positron-nb/starDust_wreckingball/Requirements_Compliance.csv

Requirement ID | Source | Exact requirement from the problem statement / template | Mandatory or design-dependent | Proposed design response | Evidence in CAD or documentation | Verification method | Status
R-01 | PS p.1, Hardware & Mechanical Constraints | Robot Structure: Must be a spherical robot (ball-shaped) with a strict diameter between 2.0 feet and 2.5 feet. | Mandatory | 700 mm (2.30 ft) PC sphere; max caliper 700.7 mm over tape band, min 696.3 mm across recessed hubs. | Dimensioned_Views.png; cad/out/analysis_results.json (dimensions); wb700_params.py D_shell | CAD caliper check over 2562 directions incl. all exterior parts (done); +/-7 mm tolerance case (done); physical go/no-go gauge check in Phase 3 | Satisfied
R-02 | PS p.1 | Internal Housing: All core computing hardware, power sources, actuators, and electronics must fit completely inside the spherical body. | Mandatory | Every electronic/power/actuator part is inside the shell; hub devices recessed in flush polar hubs. | Internal_Layout.png; Cross_Section.png; max non-skin radius 349.0 mm (recessed 1.0 mm) | CAD radius/envelope check (done); inspection in Phase 3 | Satisfied
R-03 | PS p.1 | Peripheral Limits: External sensors, mounts, or camera lenses cannot extend more than 0.5 feet beyond the surface of the outer shell. | Mandatory | No external sensors, mounts or camera pods; camera internal behind clear PC. | Dimensioned_Views.png envelope panel; analysis_results.json external_sensors_or_mounts = 0 | CAD protrusion check (done) | Satisfied
R-04 | PS p.1 | Power Supply: Must be strictly onboard battery-powered. No tethered cables, external power lines, or remote power feeds are allowed. | Mandatory | 6S1P Li-ion 21700 pack (about 97 Wh) on the steering bob; charge port used only between runs with the arming plug removed. | Power_Distribution.png; Preliminary_BOM.csv (BATTERY) | Design review (done); inspection in Phase 3 | Satisfied
R-05 | PS p.1, Deliverables | Phase 1 CAD & System Document: Complete CAD assembly illustrating internal electronic layout, center-of-gravity placement, and system architecture schematic. | Mandatory | Parametric CadQuery assembly (STEP/STL/GLB) with labelled electronics, CG figure and architecture diagrams. | cad/; figures/; Phase1_Technical_Design_Document.pdf; Phase1_CAD_Abstract.pdf | Package review against this matrix (done); organiser screening | Satisfied
R-06 | PS p.2, Format | Round 1 (Abstract & Design Audit): Online screening based on CAD models, system schematics, and dimension compliance. | Mandatory | Abstract follows the official template; CAD renders, schematics and dimension compliance included. | Phase1_CAD_Abstract.pdf/.docx/.md | Submission by the team (pending format confirmation, Q2) | Partially satisfied
R-07 | PS p.1, Deliverables | Phase 2 Technical Simulation Report: Mathematical analysis validating actuator torque across inclined planes, balance stability, and safety kill-switch mechanism implementation. | Mandatory | Preliminary quasi-static torque check only; full analysis is a Phase 2 standby workstream. | Ramp_Capability.png; FUTURE_PHASES_STANDBY.md | Phase 2 dynamic model and report | Partially satisfied
R-08 | PS p.2, Format | Round 2 (Virtual Simulation Audit): Virtual evaluation of motor sizing calculations, torque requirements for the 0.8 ft ramp, and wireless kill-switch mechanics. | Mandatory | Ramp torque relation and pendulum limit established; motor class and kill-switch architecture defined. | TDD sections 14 and 16; Ramp_Capability.png | Phase 2 report | Partially satisfied
R-09 | PS p.2, Deliverables | Phase 3 Physical Prototype: Fully operational ball bot fielded live on-campus at IIT Bombay for technical evaluation and track trials. | Mandatory | On standby; manufacturing and assembly approach defined. | TDD section 18; FUTURE_PHASES_STANDBY.md | Phase 3 build and trials | Unresolved
R-10 | PS p.2, Round 3 Day 1 | Day 1: Technical inspection (size check, weight, electrical isolation, emergency kill-switch validation) and preliminary practice runs. | Mandatory | Diameter margins; mass estimate 17.0 kg; external arming plug for isolation; 3-channel e-stop with self-test. | Dimensioned_Views.png; Center_of_Gravity.png; Power_Distribution.png | Phase 3 inspection; 'electrical isolation' definition requested (Q8) | Partially satisfied
R-11 | PS p.2, Track | Visual Guidance: Track boundaries are defined by color-coded cone barriers: Red Cones: Located on the right side of the track. Yellow Cones: Located on the left side of the track. | Design-dependent | HSV segmentation of red/yellow cones; boundary model yellow = left, red = right. | Software_Flowchart.png; Camera_FOV.png | Phase 2 dataset tests; Phase 3 calibration | Partially satisfied
R-12 | PS p.2, Sector 1 | Sector 1: The Gate Runway (0m - 15m) Straight acceleration stretch featuring wide chevron-patterned cone gates to allow onboard vision calibration. | Design-dependent | CALIBRATE state locks colour thresholds and exposure on the chevron gates while rolling slowly. | Software_Flowchart.png | Phase 2 simulation; Phase 3 runs | Partially satisfied
R-13 | PS p.2, Sector 2 | Sector 2: The Step-Up Ramps (15m - 35m) Three consecutive incline ramps with heights of 0.2 ft, 0.4 ft, and 0.8 ft, funneled through cone gates to test traction and motor torque. | Design-dependent | Pendulum capability 10.7 deg steady climb incl. rolling resistance (7.1-13.6 deg with 2-6 ballast plates); run-up energy estimate for steeper ramps (unverified); PU tape for grip. | Ramp_Capability.png; TDD section 14 | Phase 2 dynamic model once ramp geometry is known (Q3) | Partially satisfied
R-14 | PS p.2, Sector 3 | Sector 3: The Wrecking Zone (35m - 55m) Sector populated with low-density obstacles (foam, thermocol, cardboard). The robot must maintain course alignment using border cones while plowing through obstacles. | Design-dependent | Heavy low pendulum (cannot derail), PC shell, gyro heading hold + border cones, momentum of 1-1.5 m/s. | TDD sections 10 and 14 | Phase 2 impact analysis; Phase 3 barrier tests | Partially satisfied
R-15 | PS p.2, Sector 4 | Sector 4: The Pendulum Gauntlet (55m - 75m) Final hazard sector featuring a continuously swinging mechanical pendulum across the track before the finish line. | Design-dependent | Stop before swing plane, observe 2-3 swings, fit period/phase, commit and cross in the predicted window. | Software_Flowchart.png; TDD section 15 | Phase 2 Monte-Carlo timing; Phase 3 test pendulum | Partially satisfied
R-16 | PS p.3, Scoring | Each participating team is granted 3 restart attempts within their designated operational window, with only their top performance logged for official scoring. | Design-dependent | Charging through the hub port and a single-bolt service procedure support quick turnarounds. | TDD section 8.8 | Phase 3 rehearsal | Partially satisfied
R-17 | PS p.3, Scoring | FinalScore(Seconds) = RawRunTime + Penalties | Design-dependent | Reliability first, then a speed profile per sector; target top speed 2 m/s (design target, not a claim). | TDD sections 11 and 14 | Phase 2 simulation | Partially satisfied
R-18 | PS p.3, Team | Team Size: Maximum of 6 members per team. | Mandatory | Team placeholders provided for up to 6 members. | TDD section 1 | Team to confirm | Unresolved
R-19 | PS p.3, Timeline | Phase 1 Registration & CAD Abstract Submission October 25, 2026 | Mandatory | Package prepared; date confirmed on techfest.org on 2026-10-20. | research/Official_Sources_Verification.md | Team submits before the deadline | Partially satisfied
R-20 | PS p.3, General Rules 1 | All teams must register on techfest.org to receive an official Team ID for tracking and submissions. | Mandatory | Team ID placeholders in all documents. | Phase1_README.md | Team action | Unresolved
R-21 | PS p.4, General Rules 2 | Instructions for specific rounds would be communicated on time via registered mail IDs | Mandatory | Team to monitor the registered mailbox; format question Q2 prepared. | Open_Questions_for_Organizers.md | Team action | Unresolved
R-22 | PS p.4, General Rules 3 | Submissions must represent the team's original work. Using external AI tools during live rounds is strictly prohibited unless judges explicitly authorize it. | Mandatory | Package drafted with AI assistance; team must review and own every decision; disclosure question Q1 prepared. | Open_Questions_for_Organizers.md (Q1); Phase1_README.md | Team review + organiser answer | Unresolved
R-23 | PS p.4, General Rules 4 | Official announcements will be posted on techfest.org. All contest queries must be submitted through the official portal's Doubt section. | Mandatory | 13 questions prepared for the Doubts section. | Open_Questions_for_Organizers.md | Team action | Partially satisfied
R-24 | PS p.4, General Rules 6 | Autonomy: The robot must operate with 100% autonomy during its run. No manual remote control, external human intervention, or external processing offloads are allowed once the run begins. | Mandatory | All perception, estimation and planning on the Pi 5; control on the MCU; the only RF link is the inhibit-only e-stop; development laptop disconnected during runs. | System_Architecture.png | Addressed in design; verification pending (Phase 3 demonstration) | Partially satisfied
R-25 | PS p.4, General Rules 7 | Sensor Restrictions: Onboard cameras must serve as the primary sensor for path tracking and gate identification. Supplementary internal sensors (IMUs, encoders, distance sensors) are permitted for stabilization. | Mandatory | Camera Module 3 Wide is the primary sensor; IMU, encoders, shell-index and steering-angle sensors are internal. | System_Architecture.png; Electronics_Architecture.png | Design review (done) | Satisfied
R-26 | PS p.4, General Rules 8 | Cone Contact Penalties: Touching, knocking over, or running over any track cone incurs a +5 second penalty per instance added to the total run time. | Design-dependent | Lane-centring on both boundaries with margin; lean steering +/-22.9 deg static authority. | TDD sections 10 and 13 | Phase 2 simulation once track/gate width is known (Q4) | Partially satisfied
R-27 | PS p.4, General Rules 9 | Emergency Stop: Every robot must have an operational wireless emergency kill switch that can immediately stop all motor actuation during a run. | Mandatory | Heartbeat e-stop with independent supervisor: contactor open + driver PWM inputs gated to zero + changeover brake relays (break-before-make); latched; all actuators downstream of the contactor. | Power_Distribution.png; Electronics_Architecture.png; TDD section 16 | Addressed in design; verification pending (Phase 2 bench latency/fail-safe tests, Phase 3 inspection) | Partially satisfied
R-28 | PS p.4, General Rules 10 | Did Not Finish (DNF): A run is marked as DNF if the robot fails to move, loses complete control, suffers total power failure, or cannot clear an obstacle. | Design-dependent | Fail-safe stops, torque headroom management, ballast tuning, fused branches, BMS; risks tracked. | TDD section 19 | Phase 2/3 | Partially satisfied
T-01 | TPL Team identification | Team ID & Name: [Enter Team ID and Team Name] Institution: [Enter College / University Name] Team Lead Contact: [Name | Email | Phone Number] | Mandatory | Placeholders present; never invented. | Phase1_CAD_Abstract | Team to fill | Unresolved
T-02 | TPL 1 | CAD Renders Provided: [Insert Isometric View Render Link/Image] [Insert Cross-Sectional View Render Link/Image] | Mandatory | Both renders generated from the CAD. | Isometric_Render.png; Cross_Section.png | Visual inspection (done) | Satisfied
T-03 | TPL 1 | Shell Integrity: Material: [e.g., Polycarbonate / Carbon Fiber / Fiberglass] Exact Outer Diameter: [e.g., 2.2 feet] | Mandatory | Clear PC, 3 mm; OD 700.0 mm (2.297 ft); 700.7 mm over tape. | Dimensioned_Views.png | CAD (done) | Satisfied
T-04 | TPL 1 | The 0.5-Foot Limit Rule: [Dimension and confirm that all external sensor mounts or camera pods extend beyond the outer shell diameter] | Mandatory | No external mounts or pods (0 mm). | Dimensioned_Views.png | CAD (done) | Satisfied
T-05 | TPL 1 | CoG & Drive Mechanism: [Explain how the internal drive/pendulum mechanism moves and balances the robot. Provide initial calculated CoG coordinates relative to the geometric center] | Mandatory | CG (+1.4, -0.4, -87.2) mm from the CAD mass table; mechanism explained. | Center_of_Gravity.png; mass_table.csv | Reproducible calculation (done); hardware CG measurement in Phase 3 | Satisfied
T-06 | TPL 1 | Ramp-Climbing Capability: [Detail motor torque calculations and selection chosen to conquer the hardest ramp] | Mandatory | Quasi-static torque table, pendulum reaction limit, run-up speeds, motor class and selection targets. | Ramp_Capability.png; abstract section 1 | Phase 2 final sizing after ramp geometry (Q3) | Partially satisfied
T-07 | TPL 2 | Electrical Block Diagram: [Insert schematic / block diagram showing power distribution, microcontroller, sensor interfaces, and motor drivers] | Mandatory | System, electronics and power diagrams. | System_Architecture.png; Electronics_Architecture.png; Power_Distribution.png | Visual inspection (done) | Satisfied
T-08 | TPL 2 | Power Source & BMS: Confirmation: Strictly battery-powered (Yes/No) Chemistry, Voltage & Capacity: [e.g., Lithium Polymer, 24V, 5000mAh] Safeguards: [Detail onboard BMS and low-voltage cutoff (LVC) safeguards] | Mandatory | Yes; Li-ion 6S1P 21.6 V 4.5 Ah; BMS with LVC + software LVC stop + fuses. | Power_Distribution.png | Design review (done); thresholds with the selected BMS in Phase 2 | Satisfied
T-09 | TPL 2 | Actuation & Motor Control: Motor Specs: [RPM, Stall Torque] Driver Boards: [Model and specs for propulsion and steering drivers] | Mandatory | Target specs per drive motor at 24 V: >= 320 rpm no-load, >= 2 N m rated continuous, >= 4 N m stall (operating point 1.66 N m at 55 rpm, checked at 18 V); MDD20A / MD10C class drivers. | Abstract section 2; Electronics_Architecture.png | Phase 2 part selection | Partially satisfied
T-10 | TPL 2 | Safety Fail-Safes: Wireless Kill-Switch: [Outline wireless emergency kill-switch mechanism] Manual Disconnect: [Outline manual external power disconnect switch location] | Mandatory | Heartbeat e-stop (3 channels); anti-spark arming plug in the non-rotating left polar hub. | Dimensioned_Views.png (left view); Power_Distribution.png | Design review (done) | Satisfied
T-11 | TPL 3 | Software Flowchart: [Insert architecture flowchart showing state machine diagram and vision AI stack] | Mandatory | Concept-level flowchart. | Software_Flowchart.png | Visual inspection (done) | Satisfied
T-12 | TPL 3 | Primary Vision Processing / State Estimation & Control / Obstacle Handling Logic (Sector 4) | Mandatory | Concept descriptions in abstract section 3 and TDD sections 13-15. | Phase1_CAD_Abstract; TDD | Algorithms validated in Phase 2 | Partially satisfied
