positron-nb/starDust_wreckingball/Preliminary_BOM.csv

Item | Description | Group | Qty | CAD part IDs | Material / part class | Selected or reference part | Mass each (kg) | Mass total (kg) | Mass basis | CG x (mm) | CG y (mm) | CG z (mm) | Placeholder (PH) | Spec source | Notes | Cost
SHELL-HEMI | Clear polycarbonate hemisphere, OD 700 mm, 3 mm wall (R has 4 rim notches) | Shell + equatorial joint + tape | 2 | SH-01 SH-02 | Polycarbonate, clear | to be sourced (thermoformed PC dome) | 2.6984 (avg) | 5.3968 | CAD volume x density | 0.0 | -0.0 | 0.0 | no | design parameter | supplier, tolerance and wall uniformity to be confirmed (risk R9) | not quoted (Phase 3 procurement)
SPIGOT-BAND | Equatorial spigot band + 4 key tabs, clear PC 5 mm | Shell + equatorial joint + tape | 1 | SH-03 | Polycarbonate, clear |  | 0.3903 | 0.3903 | CAD volume x density | 0.0 | 0.0 | 0.0 | no |  | bonded in L hemisphere; R hemisphere slides over; held by axial preload through axle | not quoted (Phase 3 procurement)
PU-TAPE | Clear PU protective tape band, 0.35 mm (applied in narrow strips) | Shell + equatorial joint + tape | 1 | SH-04 | TPU film 0.35 mm | 3M 8671 / 8671HS class | 0.1848 | 0.1848 | CAD volume x density | 0.0 | 0.0 | 0.0 | no | 3M TDS: transparent TPU, 0.014 in | sacrificial, replaceable; protects rolling band / camera view, adds grip; counted in OD | not quoted (Phase 3 procurement)
POLE-FLANGE | Pole flange with bearing seat (PA12-CF print + Al insert) | Polar interface (flanges, bearings, hubs, hub devices, bolt) | 2 | SH-10 SH-11 | PA12-CF print + Al bearing insert |  | 0.2383 | 0.4766 | CAD volume x density | 0.0 | 0.0 | 0.0 | no |  | bonded + screwed to shell around polar opening | not quoted (Phase 3 procurement)
RING-GEAR | Ring gear 72T m1.5, face 12 mm (POM-C), bored | Twin drive (gearmotors, pinions, arms, ring gears) | 2 | SH-20 SH-21 | POM-C (acetal) | stock m1.5 72T POM spur gear, re-bored | 0.0940 | 0.1880 | CAD volume x density (simplified teeth) | 0.0 | 0.0 | 0.0 | no | CAD volume (simplified teeth) | bolted to flange web; slides axially out of mesh when hemisphere is removed | not quoted (Phase 3 procurement)
POLE-BEARING | Deep-groove bearing 61908-2RS (6908), 40 x 62 x 12 mm | Polar interface (flanges, bearings, hubs, hub devices, bolt) | 2 | SH-30 SH-31 | steel (purchased) | 61908-2RS (6908-2RS) | 0.1100 | 0.2200 | estimate (catalogue-class) | 0.0 | 0.0 | 0.0 | no | ISO 15 standard dimensions; mass estimated | interface stator/shell; axisymmetric | not quoted (Phase 3 procurement)
AXLE | Stationary axle tube 30 x 3 mm, 6061-T6, 624 mm | Stator structure (axle, plates, clamps, fasteners) | 1 | ST-01 | Al 6061-T6 |  | 0.4287 | 0.4287 | CAD volume x density | 0.0 | 0.0 | 0.0 | no |  | does not rotate with shell; carries hub harness inside (no slip ring) | not quoted (Phase 3 procurement)
HUB-LEFT | Left polar hub (non-rotating, flush): cap, cup, boss | Polar interface (flanges, bearings, hubs, hub devices, bolt) | 1 | ST-02 | PA12-CF print, Al boss |  | 0.2196 | 0.2196 | CAD volume x density | -0.3 | 330.8 | -0.4 | no |  | LEFT: manual external disconnect + charge port + status LED | not quoted (Phase 3 procurement)
HUB-RIGHT | Right polar hub (non-rotating, flush) | Polar interface (flanges, bearings, hubs, hub devices, bolt) | 1 | ST-03 | PA12-CF print, Al boss |  | 0.2236 | 0.2236 | CAD volume x density | 0.0 | -331.0 | 0.0 | no |  | RIGHT: M12 preload bolt clamps hemispheres through the axle | not quoted (Phase 3 procurement)
ARMING-PLUG | Anti-spark arming plug + receptacle (XT90-S class) - manual disconnect | Polar interface (flanges, bearings, hubs, hub devices, bolt) | 1 | PW-04 | purchased | XT90-S anti-spark class | 0.0300 | 0.0300 | estimate | 25.0 | 338.5 | 10.0 | yes | class-level PH | recessed 2-3 mm below hub cap; pulling it isolates the battery | not quoted (Phase 3 procurement)
CHARGE-PORT | Charge port receptacle (BMS charge input) | Polar interface (flanges, bearings, hubs, hub devices, bolt) | 1 | PW-05 | purchased |  | 0.0060 | 0.0060 | estimate | -30.0 | 338.0 | 17.0 | yes |  |  | not quoted (Phase 3 procurement)
STATUS-LED | Status LED (RGB, panel) | Polar interface (flanges, bearings, hubs, hub devices, bolt) | 1 | SA-03 | purchased |  | 0.0020 | 0.0020 | estimate | -25.0 | 338.5 | -22.0 | yes |  |  | not quoted (Phase 3 procurement)
PRELOAD-BOLT | M12 preload bolt + disc-spring stack + axle end plug | Polar interface (flanges, bearings, hubs, hub devices, bolt) | 1 | ST-04 | steel |  | 0.0444 | 0.0444 | CAD volume x density | 0.0 | -323.2 | 0.0 | no |  | single fastener opens the ball | not quoted (Phase 3 procurement)
SIDE-PLATE | Stator side plate, 6061 3 mm, laser-cut | Stator structure (axle, plates, clamps, fasteners) | 2 | ST-10 ST-11 | Al 6061 3 mm |  | 0.1994 | 0.3988 | CAD volume x density | 0.0 | 0.0 | -26.0 | no |  |  | not quoted (Phase 3 procurement)
END-PLATE | Stator front/rear plate, 6061 3 mm, laser-cut | Stator structure (axle, plates, clamps, fasteners) | 2 | ST-12 ST-13 | Al 6061 3 mm |  | 0.1522 | 0.3044 | CAD volume x density | 0.0 | 0.0 | -24.6 | no |  |  | not quoted (Phase 3 procurement)
AXLE-CLAMP | Split axle clamp block, 6061 | Stator structure (axle, plates, clamps, fasteners) | 2 | ST-14 ST-15 | Al 6061 |  | 0.0483 | 0.0966 | CAD volume x density | 0.0 | 0.0 | 0.0 | no |  |  | not quoted (Phase 3 procurement)
GEARMOTOR | 24 V brushed DC planetary gearmotor with Hall encoder, 42 mm class | Twin drive (gearmotors, pinions, arms, ring gears) | 2 | DR-01 DR-02 | purchased | TBD in Phase 2 | 0.6200 | 1.2400 | estimate for 42 mm planetary class | 0.0 | 0.0 | -43.4 | yes | targets: >= 320 rpm no-load @ 24 V, >= 2 N m rated continuous, >= 4 N m stall | PLACEHOLDER envelope 42 x 145 mm | not quoted (Phase 3 procurement)
PINION | Pinion 18T m1.5, steel | Twin drive (gearmotors, pinions, arms, ring gears) | 2 | DR-03 DR-04 | steel | stock m1.5 18T steel spur gear | 0.0338 | 0.0676 | CAD volume x density | 0.0 | 0.0 | -43.4 | no | CAD volume (simplified teeth) |  | not quoted (Phase 3 procurement)
MOTOR-ARM | Motor arm clamped to axle, 6061 6 mm (slotted) | Twin drive (gearmotors, pinions, arms, ring gears) | 2 | DR-05 DR-06 | Al 6061 6 mm |  | 0.0835 | 0.1670 | CAD volume x density | 0.0 | 0.0 | -24.4 | no |  |  | not quoted (Phase 3 procurement)
PIVOT-SHAFT | Steering pivot shaft, 12 mm steel | Steering mechanism (pivot, bearings, worm motor, stops, hangers, tray, brackets) | 1 | SG-01 | steel |  | 0.2566 | 0.2566 | CAD volume x density | 4.5 | 0.0 | -45.0 | no |  | driven end at front; sensor magnet at rear | not quoted (Phase 3 procurement)
PIVOT-BEARING | Pivot bearing 6001-2RS + housing | Steering mechanism (pivot, bearings, worm motor, stops, hangers, tray, brackets) | 2 | SG-02 SG-03 | steel/Al |  | 0.0350 | 0.0700 | estimate | 0.0 | 0.0 | -45.0 | no |  |  | not quoted (Phase 3 procurement)
STEER-MOTOR | Self-locking worm gearmotor (steering) | Steering mechanism (pivot, bearings, worm motor, stops, hangers, tray, brackets) | 1 | SG-04 | purchased | JGY-370 worm class (TBD) | 0.1600 | 0.1600 | estimate (JGY-370 worm class) | 137.0 | 10.0 | -54.9 | yes | target >= 4 N m, >= 30 rpm | PLACEHOLDER | not quoted (Phase 3 procurement)
STEER-ANGLE | Magnetic angle sensor + magnet (steering pivot) | Camera, servo and sensors | 1 | SE-04 | purchased | AS5600 class (reference) | 0.0040 | 0.0040 | estimate | -144.0 | 0.0 | -45.0 | yes | class-level PH |  | not quoted (Phase 3 procurement)
TILT-STOP | Rubber tilt end-stop | Steering mechanism (pivot, bearings, worm motor, stops, hangers, tray, brackets) | 4 | SG-10 SG-11 SG-12 SG-13 | NBR rubber |  | 0.0016 | 0.0064 | CAD volume x density | 0.0 | 0.0 | -75.0 | no |  | engages a stop tab on the hanger at ~32 deg (tab not modelled) | not quoted (Phase 3 procurement)
CAMERA | Raspberry Pi Camera Module 3 Wide | Camera, servo and sensors | 1 | SE-01 | purchased | Raspberry Pi Camera Module 3 Wide | 0.0040 | 0.0040 | datasheet dims; mass est. | 152.2 | 50.0 | 22.0 | no | RPi product brief (2024): 25 x 24 x 12.4 mm, 102 x 67 deg | mass estimated | not quoted (Phase 3 procurement)
CAM-SERVO | Metal-gear micro servo (camera pitch) | Camera, servo and sensors | 1 | SE-02 | purchased |  | 0.0140 | 0.0140 | estimate (MG90S class) | 138.5 | 69.0 | 17.2 | yes |  |  | not quoted (Phase 3 procurement)
IMU | 9-DoF IMU breakout | Camera, servo and sensors | 1 | SE-03 | purchased | BNO085 class (reference) | 0.0060 | 0.0060 | estimate | 0.0 | 0.0 | 17.0 | yes | class-level PH | 22 mm from the pitch axis to limit tangential-acceleration error | not quoted (Phase 3 procurement)
HALL-INDEX | Hall sensor + magnet (shell index) | Camera, servo and sensors | 1 | SE-05 | purchased |  | 0.0020 | 0.0020 | estimate | 30.5 | 279.0 | -25.5 | yes |  |  | not quoted (Phase 3 procurement)
PI5 | Raspberry Pi 5, 8 GB + active cooler | Compute (Pi 5, MCU) | 1 | CP-01 | purchased | Raspberry Pi 5 (8 GB) | 0.0700 | 0.0700 | estimate | -136.5 | -43.5 | 2.0 | yes | RPi product brief: 85 x 56 mm, 5 V / 5 A | mass estimated | not quoted (Phase 3 procurement)
MCU-BOARD | Motor-control MCU carrier board (RP2350 class) | Compute (Pi 5, MCU) | 1 | CP-02 | purchased | Raspberry Pi Pico 2 (RP2350) on custom carrier (reference) | 0.0400 | 0.0400 | estimate | -132.5 | 43.0 | -5.0 | yes | class-level PH | real-time loops, encoders, watchdog I/O | not quoted (Phase 3 procurement)
DRIVE-DRIVER | Dual-channel brushed DC motor driver, 20 A/ch | Motor drivers | 1 | DV-01 | purchased | Cytron MDD20A class | 0.0900 | 0.0900 | estimate | 64.5 | 102.5 | -39.5 | yes | retailer listing: 6-30 V, 20 A cont./ch, 60 A peak | 6-30 V, 20 A cont./ch (retailer data) | not quoted (Phase 3 procurement)
STEER-DRIVER | Single-channel brushed DC motor driver, 13 A | Motor drivers | 1 | DV-02 | purchased | Cytron MD10C class | 0.0450 | 0.0450 | estimate | -67.5 | 100.0 | -38.5 | yes | retailer listing: 5-30 V, 13 A cont. | 5-30 V, 13 A cont. (retailer data) | not quoted (Phase 3 procurement)
PDB | Power distribution board: fuses, bus monitor, bus bars | Power electronics (PDB, DC-DC) | 1 | PW-01 | purchased |  | 0.0800 | 0.0800 | estimate | 60.0 | -100.5 | -47.5 | yes |  |  | not quoted (Phase 3 procurement)
DCDC-5V | DC-DC converter 24 V -> 5.1 V / 5 A | Power electronics (PDB, DC-DC) | 1 | PW-02 | purchased |  | 0.0350 | 0.0350 | estimate | 47.5 | -97.5 | 0.5 | yes |  |  | not quoted (Phase 3 procurement)
DCDC-6V | DC-DC converter 24 V -> 6 V / 3 A | Power electronics (PDB, DC-DC) | 1 | PW-03 | purchased |  | 0.0150 | 0.0150 | estimate | -85.0 | 95.0 | 0.0 | yes |  |  | not quoted (Phase 3 procurement)
CONTACTOR | Motor-power contactor / relay, NO, 24 V coil, 40 A | Safety hardware (contactor, brake relays, supervisor) | 1 | SA-01 | purchased |  | 0.0400 | 0.0400 | estimate | -85.0 | -105.0 | -45.0 | yes |  |  | not quoted (Phase 3 procurement)
BRAKE-RELAYS | Dynamic-brake relays (NC) + braking resistors | Safety hardware (contactor, brake relays, supervisor) | 1 | SA-02 | purchased |  | 0.0600 | 0.0600 | estimate | -47.5 | -102.5 | -42.5 | yes |  |  | not quoted (Phase 3 procurement)
ESTOP-SUPERVISOR | E-stop receiver + safety supervisor board + watchdog IC | Safety hardware (contactor, brake relays, supervisor) | 1 | SA-04 | purchased | ESP32-C3 class + TPS3823 class watchdog (reference) | 0.0300 | 0.0300 | estimate | 131.0 | -55.0 | 3.7 | yes | class-level PH | heartbeat-based fail-safe link; drives channel A and B | not quoted (Phase 3 procurement)
HARNESS | Wiring harness and cable-routing allowance | Wiring harness (allowance) | 5 | HR-01 HR-02 HR-03 HR-04 HR-05 | wiring |  | 0.0600 (avg) | 0.3000 | estimate | 24.0 | 8.3 | -27.0 | yes |  | cable-routing space reservation | not quoted (Phase 3 procurement)
FASTENERS | Fasteners, angle brackets, standoffs (allowance) | Stator structure (axle, plates, clamps, fasteners) | 1 | ST-20 | mixed |  | 0.2500 | 0.2500 | estimate | 0.0 | 0.0 | 26.5 | yes |  | lumped mass at frame top (conservative) | not quoted (Phase 3 procurement)
BOB-HANGER | Steering-bob hanger plate, 6061 5 mm | Steering mechanism (pivot, bearings, worm motor, stops, hangers, tray, brackets) | 2 | BB-01 BB-02 | Al 6061 5 mm |  | 0.1596 | 0.3192 | CAD volume x density | 0.0 | 0.0 | -159.0 | no |  |  | not quoted (Phase 3 procurement)
BOB-TRAY | Battery tray, 6061 4 mm | Steering mechanism (pivot, bearings, worm motor, stops, hangers, tray, brackets) | 1 | BB-03 | Al 6061 4 mm |  | 0.1814 | 0.1814 | CAD volume x density | 0.0 | 0.0 | -248.0 | no |  |  | not quoted (Phase 3 procurement)
BATTERY | Battery 6S1P 21700 Li-ion + 6S BMS + wrap | Battery 6S1P + BMS | 1 | PW-10 | purchased | 6 x Molicel INR-21700-P45B + 6S BMS (>= 40 A) | 0.5100 | 0.5100 | 6 x 70 g cells (datasheet max) + BMS/wiring estimate | 0.0 | 0.0 | -229.0 | yes | Molicel datasheet: 4.5 Ah, 45 A cont., <= 70 g, 21.4 x 70.0 mm | 21.6 V nom., ~97 Wh (< 100 Wh) | not quoted (Phase 3 procurement)
BALLAST-PLATE | Ballast arc plate, laser-cut 8 mm steel, R215-R265 about the pivot axis | Ballast arc plates | 4 | BL-01 BL-02 BL-03 BL-04 | S275 steel |  | 1.0522 | 4.2088 | CAD volume x density | 0.0 | 0.0 | -266.8 | no |  | arc centred on pivot axis -> constant clearance through tilt; count is the CG tuning knob | not quoted (Phase 3 procurement)
BALLAST-BRACKET | Ballast clamp bracket + 2 x M6 tie-rods | Steering mechanism (pivot, bearings, worm motor, stops, hangers, tray, brackets) | 2 | BB-04 BB-05 | Al/steel |  | 0.0600 | 0.1200 | estimate | 0.0 | 0.0 | -254.8 | no |  |  | not quoted (Phase 3 procurement)
ESTOP-TX | Handheld wireless e-stop transmitter (latching mushroom switch, ESP32 class) | Off-robot support equipment | 1 |  |  |  |  | n/a (off-robot) |  |  |  |  | yes |  |  | not quoted (Phase 3 procurement)
CHARGER | 6S Li-ion CC/CV charger, 25.2 V, <= 4.5 A | Off-robot support equipment | 1 |  |  |  |  | n/a (off-robot) |  |  |  |  | yes |  |  | not quoted (Phase 3 procurement)
SERVICE-STAND | Service stand (holds the ball left-hub-down for opening) | Off-robot support equipment | 1 |  |  |  |  | n/a (off-robot) |  |  |  |  | yes |  |  | not quoted (Phase 3 procurement)
GAUGES | Go/no-go ring gauges 2.0 ft and 2.5 ft (QC) | Off-robot support equipment | 2 |  |  |  |  | n/a (off-robot) |  |  |  |  | yes |  |  | not quoted (Phase 3 procurement)
