positron-nb/starDust_wreckingball/cad/out/WB700_Phase1_Assembly.step

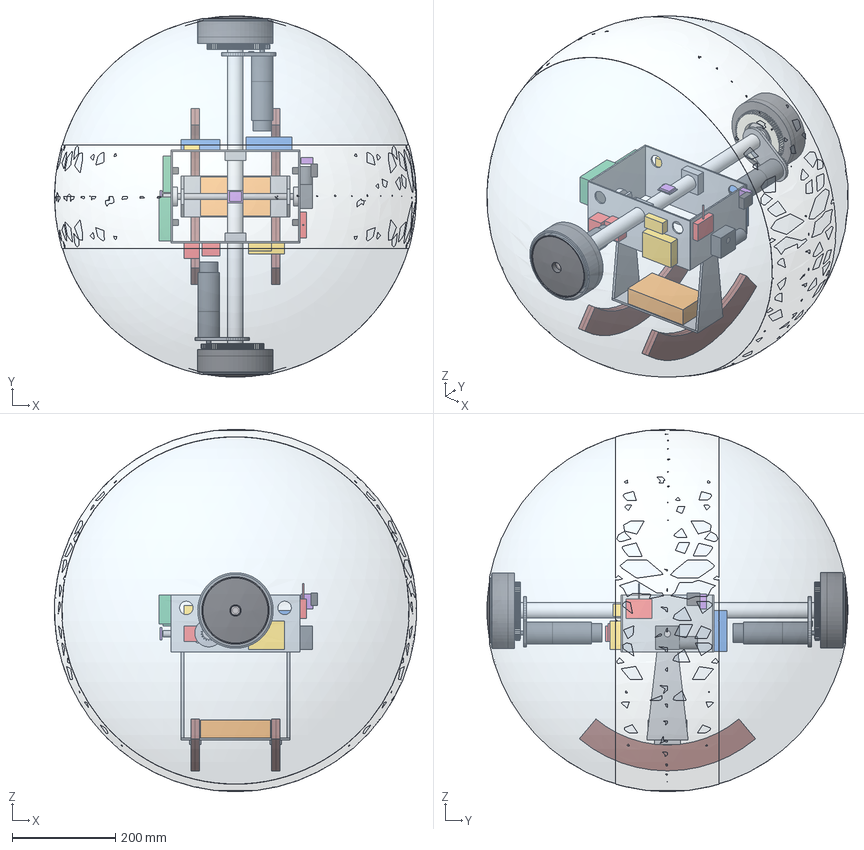
[picture p31: CAD file, 2026-10-28]
cad/out/WB700_Phase1_Assembly.step
700.1 x 697.8 x 700.7 mm
SH_01
SH_02
SH_03
SH_04
SH_10
SH_20
SH_30
SH_11
SH_21
SH_31
ST_01
ST_02
ST_03
PW_04
PW_05
SA_03
ST_04
ST_10
ST_11
ST_12
ST_13
ST_14
ST_15
DR_01
DR_03
DR_05
DR_02
DR_04
DR_06
SG_01
SG_02
SG_03
SG_04
SE_04
SG_10
SG_11
SG_12
SG_13
SE_01
SE_02
SE_03
SE_05
CP_01
CP_02
DV_01
DV_02
PW_01
PW_02
PW_03
SA_01
SA_02
SA_04
HR_01
HR_02
HR_03
HR_04
HR_05
ST_20
BB_01
BB_02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
