positron-nb/starDust_wreckingball/cad/out/stl/BB-03.stl

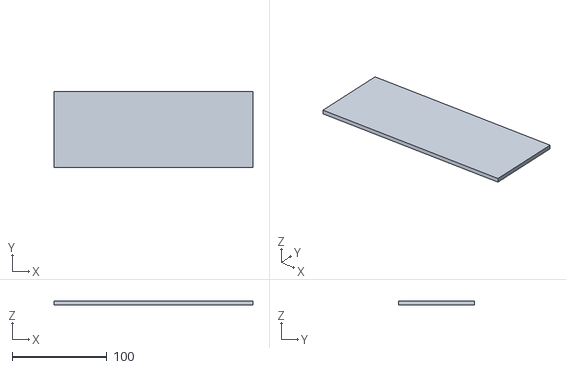
[picture p32: CAD file, 2026-10-28]
cad/out/stl/BB-03.stl
210.0 x 80.0 x 4.00
