positron-nb/starDust_wreckingball/cad/out/stl/SH-04.stl

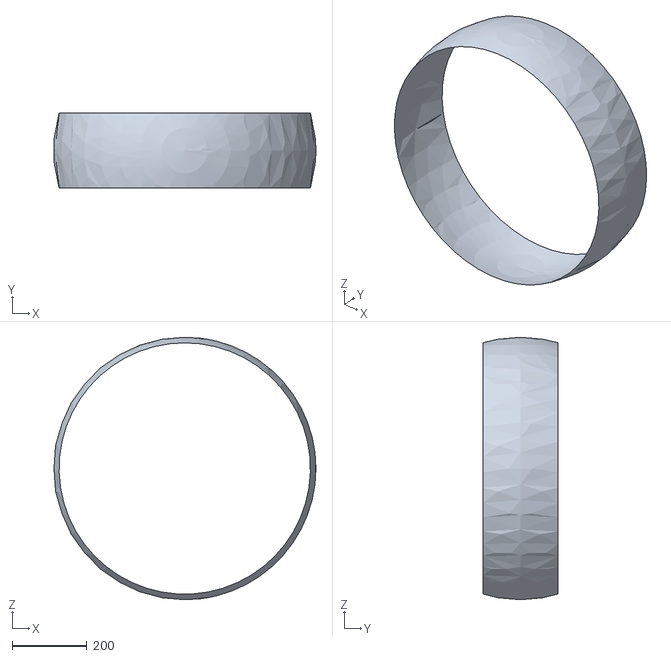
[picture p33: CAD file, 2026-10-28]
cad/out/stl/SH-04.stl
699.4 x 200.0 x 700.7
