positron-nb/starDust_wreckingball/cad/out/stl/DR-01.stl

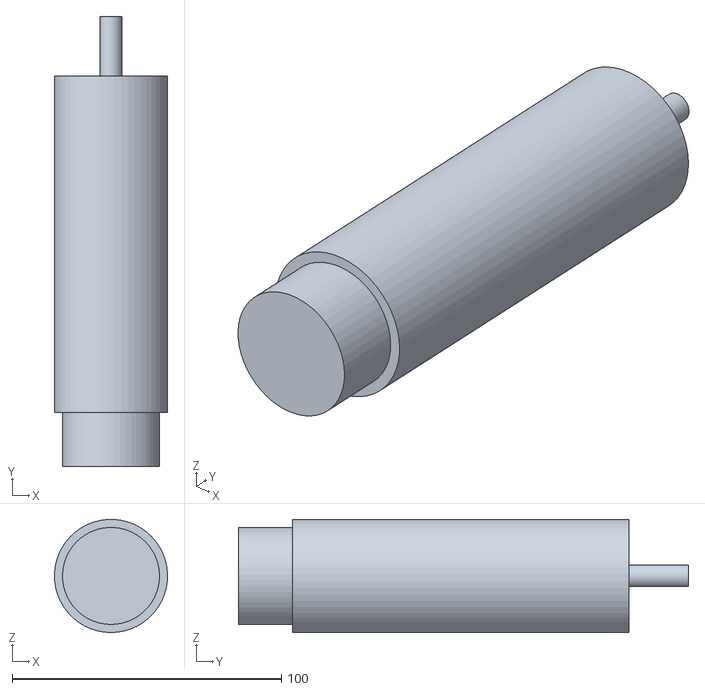
[picture p34: CAD file, 2026-10-28]
cad/out/stl/DR-01.stl
42.0 x 167.0 x 42.0
