positron-nb/starDust_wreckingball/cad/out/stl/SE-03.stl

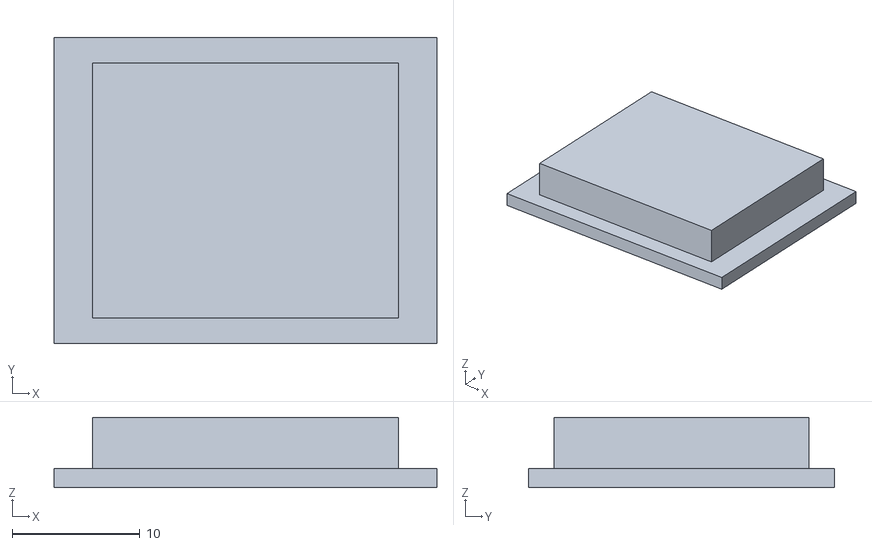
[picture p35: CAD file, 2026-10-28]
cad/out/stl/SE-03.stl
30.0 x 24.0 x 5.50
