positron-nb/starDust_wreckingball/cad/out/stl/HR-01.stl

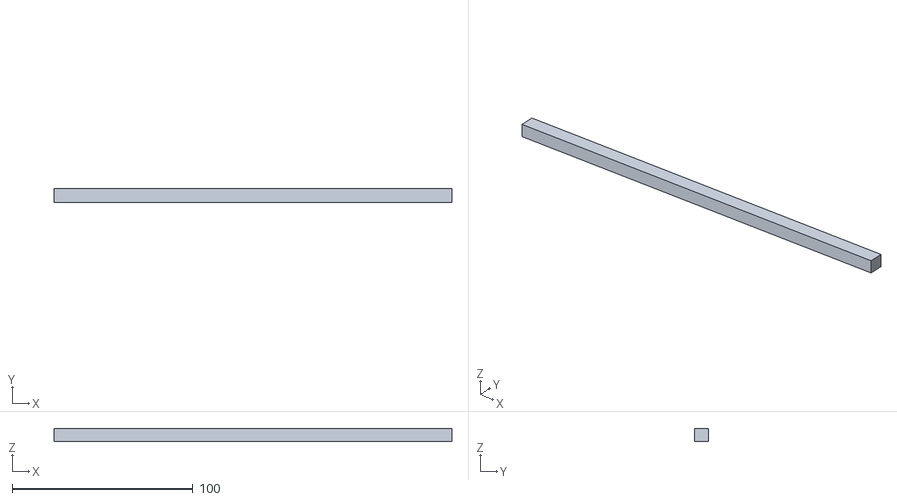
[picture p36: CAD file, 2026-10-28]
cad/out/stl/HR-01.stl
220.0 x 8.00 x 7.00
