positron-nb/starDust_wreckingball/cad/out/stl/PW-03.stl

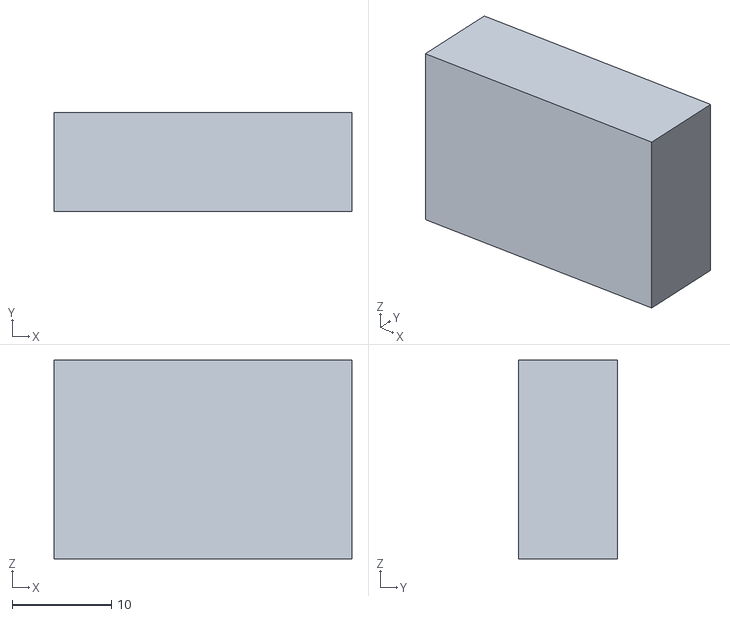
[picture p37: CAD file, 2026-10-28]
cad/out/stl/PW-03.stl
30.0 x 10.0 x 20.0
