positron-nb/starDust_wreckingball/cad/out/stl/SA-02.stl

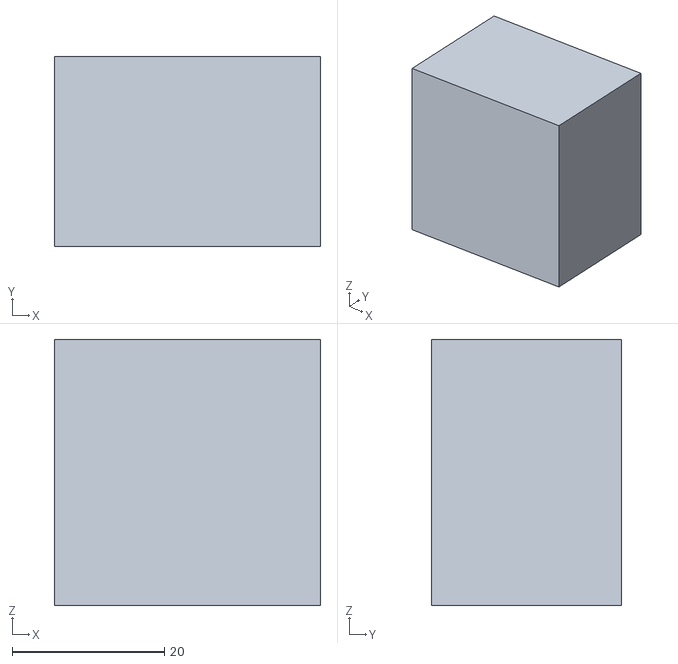
[picture p38: CAD file, 2026-10-28]
cad/out/stl/SA-02.stl
35.0 x 25.0 x 35.0
