positron-nb/starDust_wreckingball/cad/out/stl/DR-05.stl

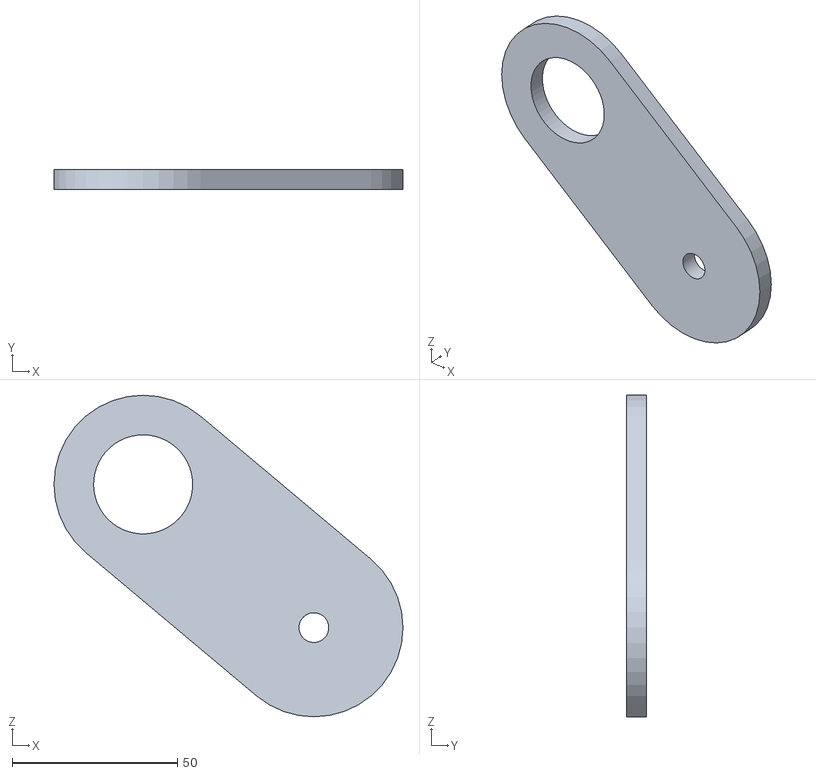
[picture p39: CAD file, 2026-10-28]
cad/out/stl/DR-05.stl
105.7 x 6.00 x 97.4
