positron-nb/starDust_wreckingball/cad/out/stl/SG-03.stl

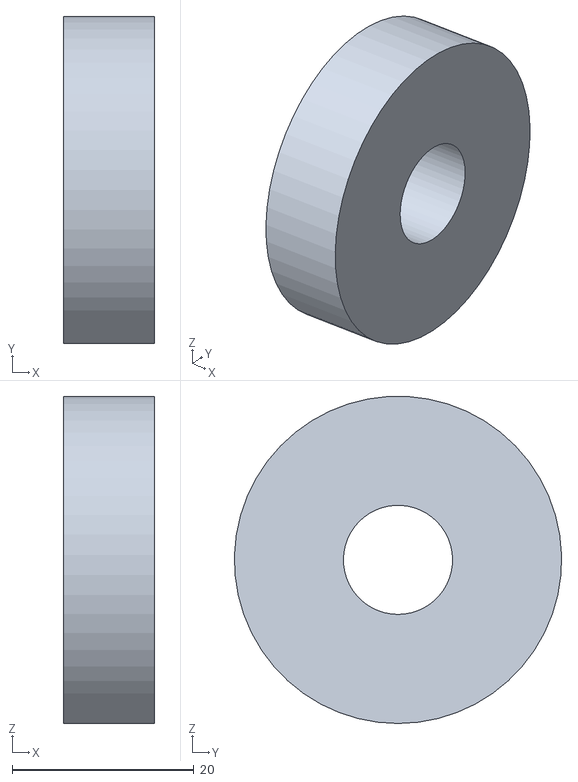
[picture p40: CAD file, 2026-10-28]
cad/out/stl/SG-03.stl
10.0 x 36.0 x 36.0
