positron-nb/starDust_wreckingball/cad/out/stl/BL-02.stl

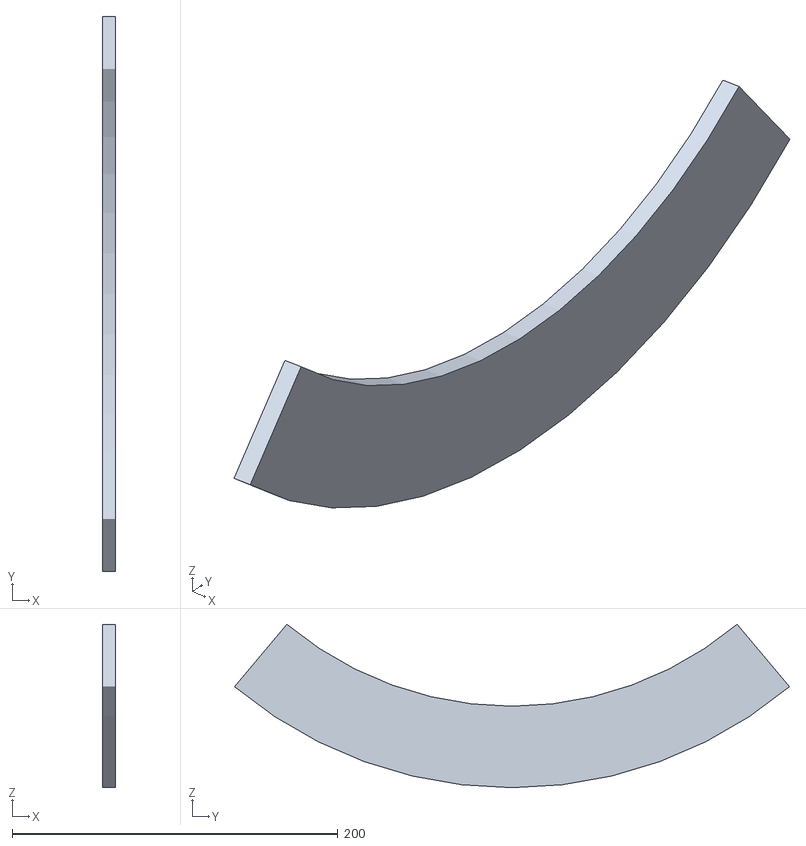
[picture p41: CAD file, 2026-10-28]
cad/out/stl/BL-02.stl
8.00 x 340.7 x 100.3
