positron-nb/starDust_wreckingball/cad/out/stl/SH-10.stl

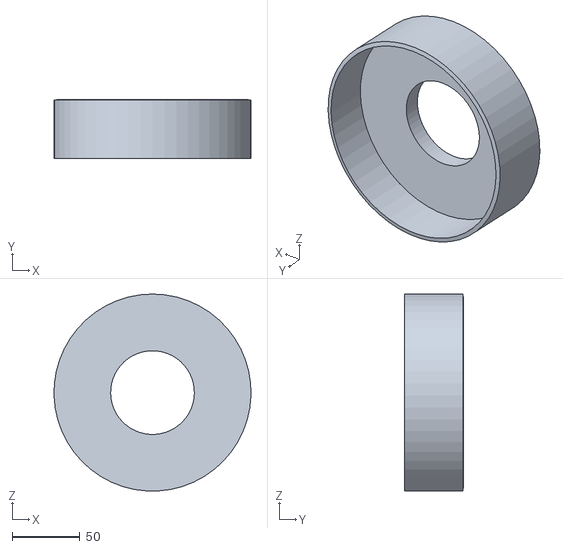
[picture p42: CAD file, 2026-10-28]
cad/out/stl/SH-10.stl
145.9 x 43.9 x 145.9
