positron-nb/starDust_wreckingball/cad/out/stl/SG-13.stl

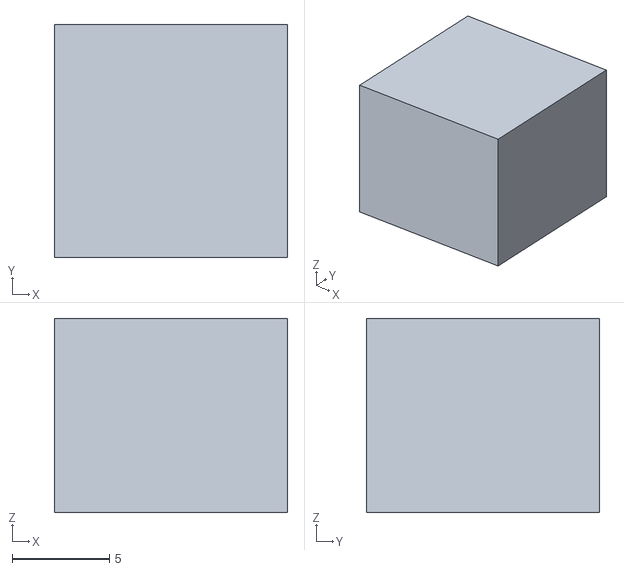
[picture p43: CAD file, 2026-10-28]
cad/out/stl/SG-13.stl
12.0 x 12.0 x 10.0
