positron-nb/starDust_wreckingball/cad/out/stl/SH-01.stl

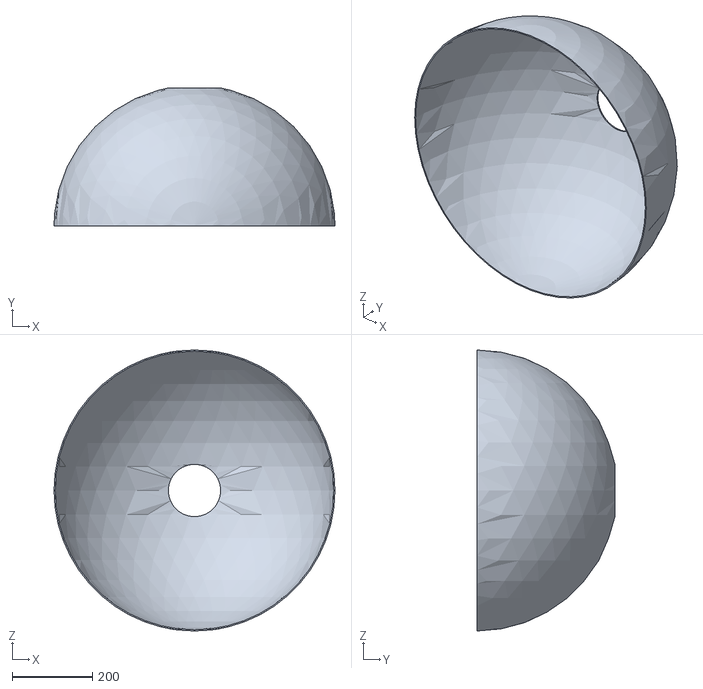
[picture p44: CAD file, 2026-10-28]
cad/out/stl/SH-01.stl
700.0 x 343.9 x 700.0
