positron-nb/starDust_wreckingball/cad/out/stl/CP-02.stl

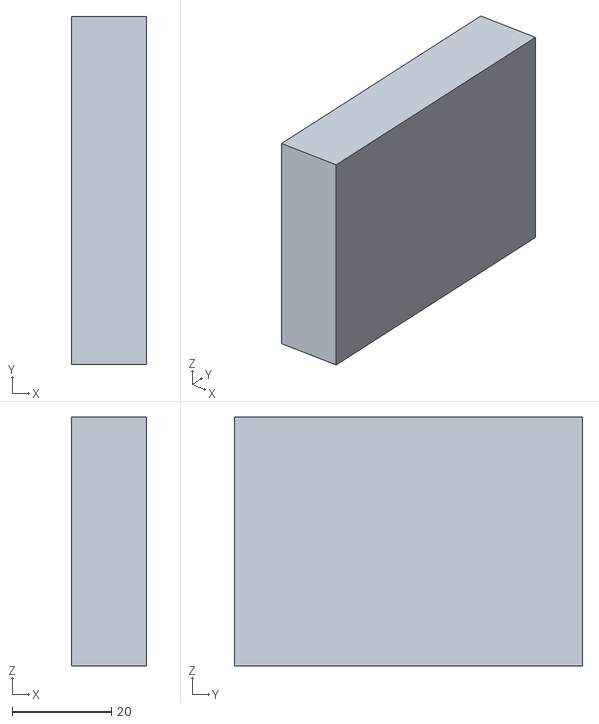
[picture p45: CAD file, 2026-10-28]
cad/out/stl/CP-02.stl
15.0 x 70.0 x 50.0
