positron-nb/starDust_wreckingball/cad/out/stl/HR-04.stl

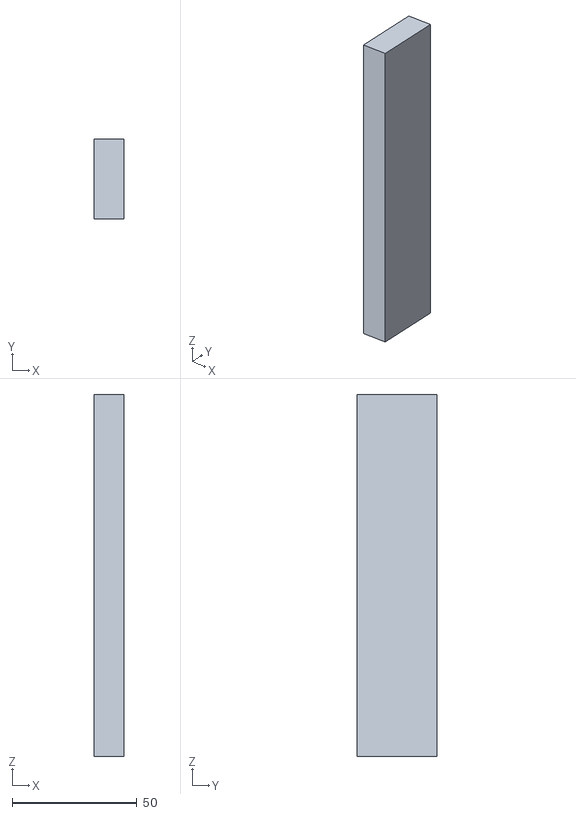
[picture p46: CAD file, 2026-10-28]
cad/out/stl/HR-04.stl
12.0 x 32.0 x 145.0
