positron-nb/starDust_wreckingball/cad/out/stl/HR-05.stl

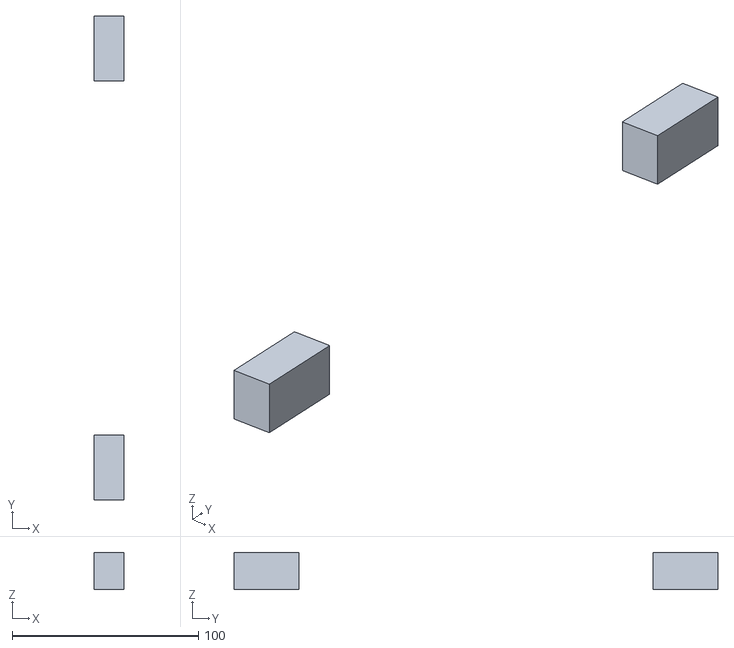
[picture p47: CAD file, 2026-10-28]
cad/out/stl/HR-05.stl
16.0 x 260.0 x 20.0
