positron-nb/starDust_wreckingball/cad/out/stl/CP-01.stl

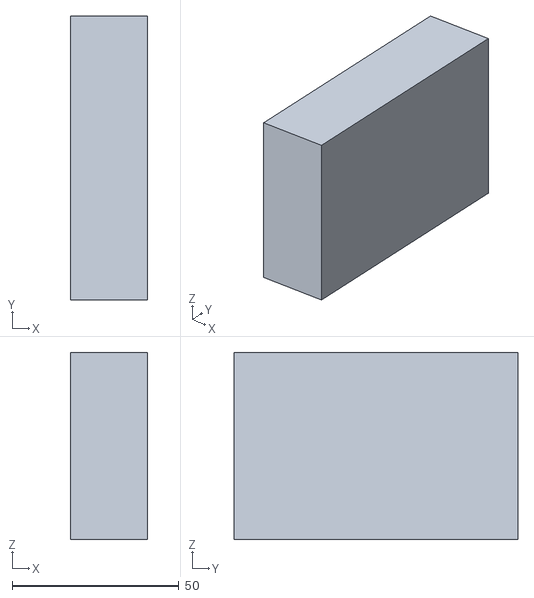
[picture p48: CAD file, 2026-10-28]
cad/out/stl/CP-01.stl
23.0 x 85.0 x 56.0
