positron-nb/starDust_wreckingball/cad/out/stl/ST-12.stl

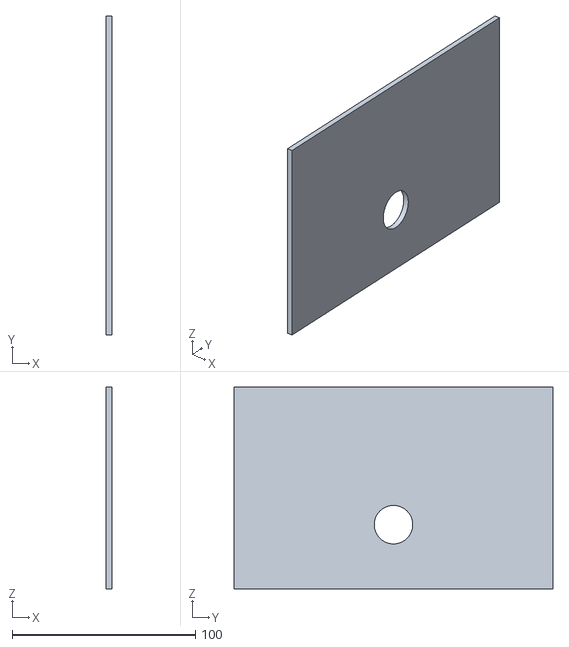
[picture p49: CAD file, 2026-10-28]
cad/out/stl/ST-12.stl
3.00 x 174.0 x 110.0
