positron-nb/starDust_wreckingball/cad/out/stl/BB-05.stl

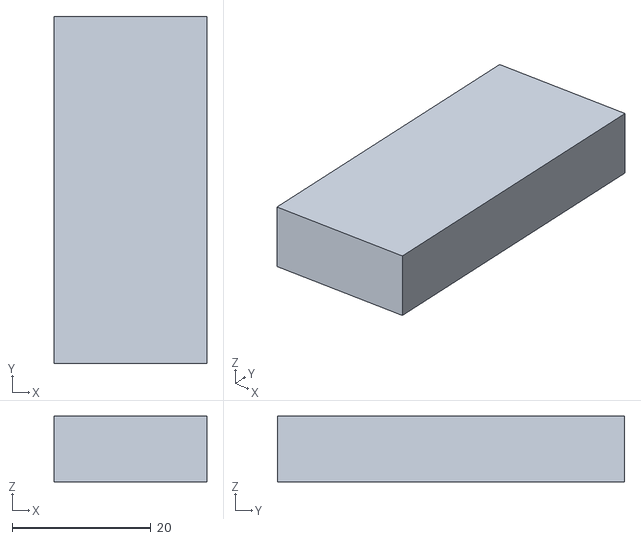
[picture p50: CAD file, 2026-10-28]
cad/out/stl/BB-05.stl
22.0 x 50.0 x 9.50
