positron-nb/starDust_wreckingball/cad/out/stl/SH-31.stl

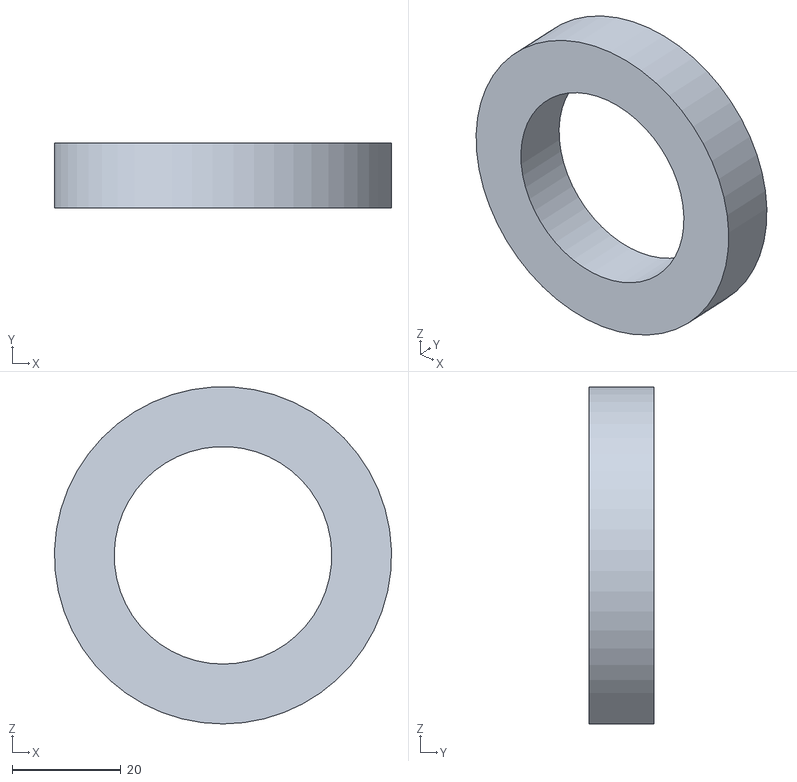
[picture p51: CAD file, 2026-10-28]
cad/out/stl/SH-31.stl
62.0 x 12.0 x 61.9
