positron-nb/starDust_wreckingball/cad/out/stl/PW-04.stl

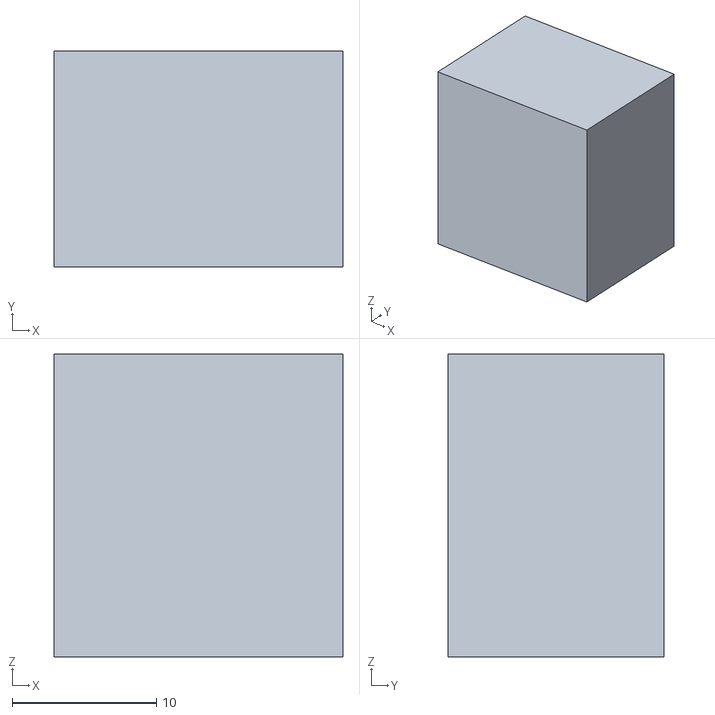
[picture p52: CAD file, 2026-10-28]
cad/out/stl/PW-04.stl
20.0 x 15.0 x 21.0
