positron-nb/starDust_wreckingball/cad/out/stl/SG-04.stl

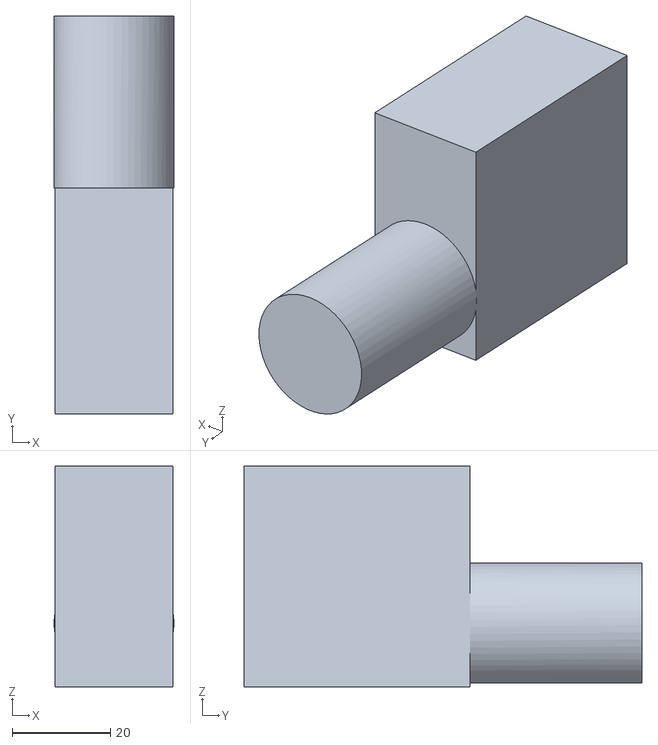
[picture p53: CAD file, 2026-10-28]
cad/out/stl/SG-04.stl
24.4 x 81.0 x 45.0
