positron-nb/starDust_wreckingball/cad/out/stl/PW-10.stl

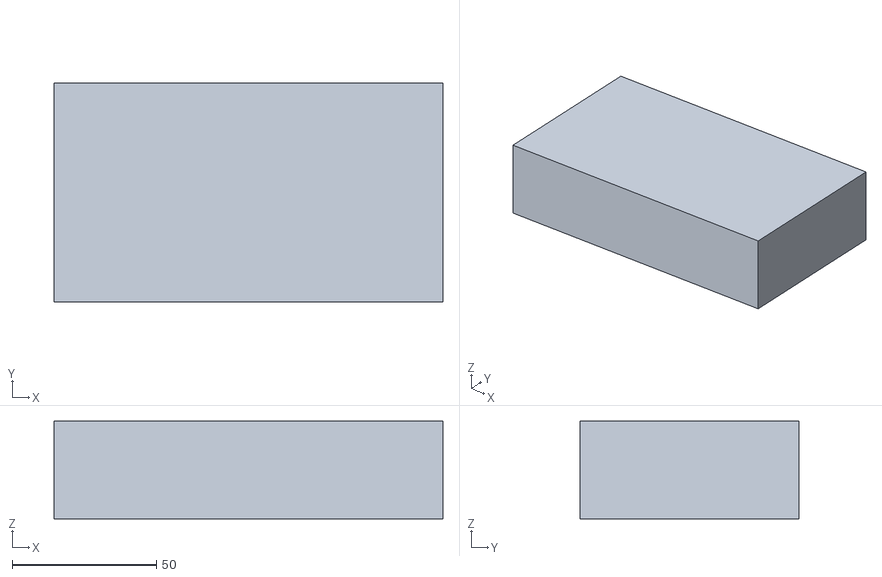
[picture p54: CAD file, 2026-10-28]
cad/out/stl/PW-10.stl
135.0 x 76.0 x 34.0
