positron-nb/starDust_wreckingball/cad/out/stl/SE-05.stl

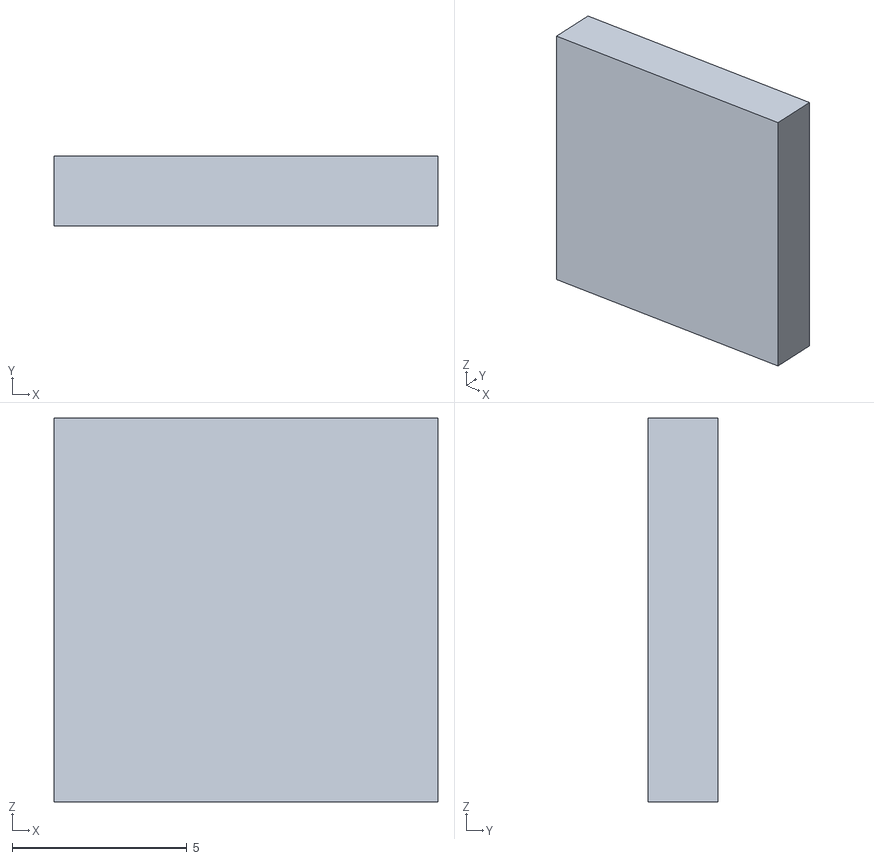
[picture p55: CAD file, 2026-10-28]
cad/out/stl/SE-05.stl
11.0 x 2.00 x 11.0
