positron-nb/starDust_wreckingball/cad/out/stl/SE-01.stl

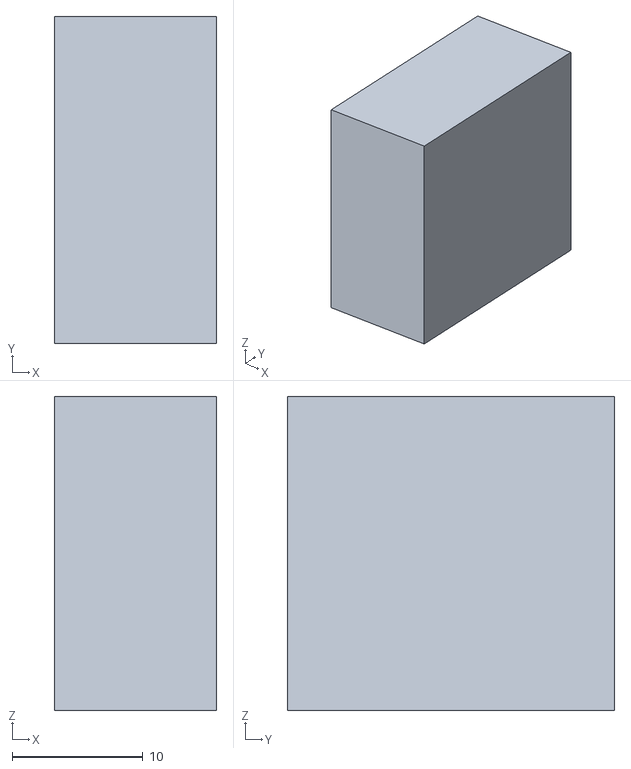
[picture p56: CAD file, 2026-10-28]
cad/out/stl/SE-01.stl
12.4 x 25.0 x 24.0
