positron-nb/starDust_wreckingball/cad/out/stl/SE-04.stl

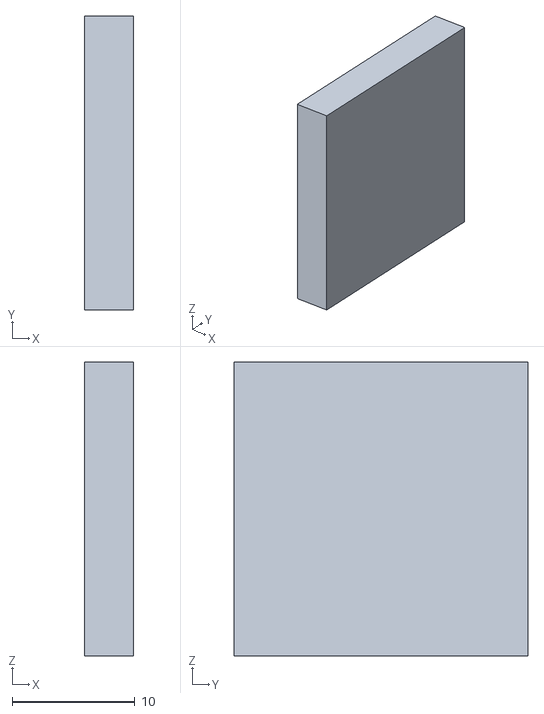
[picture p57: CAD file, 2026-10-28]
cad/out/stl/SE-04.stl
4.00 x 24.0 x 24.0
