positron-nb/starDust_wreckingball/cad/out/stl/PW-05.stl

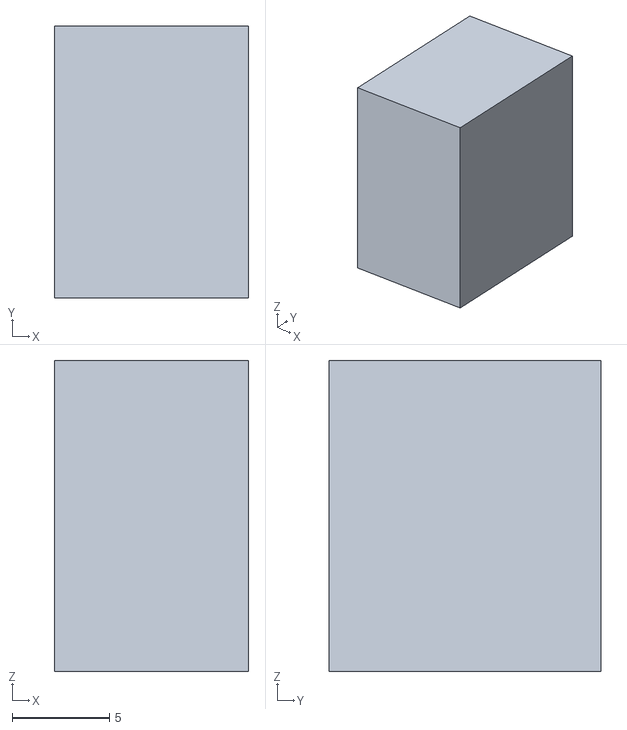
[picture p58: CAD file, 2026-10-28]
cad/out/stl/PW-05.stl
10.0 x 14.0 x 16.0
