positron-nb/starDust_wreckingball/cad/out/stl/ST-11.stl

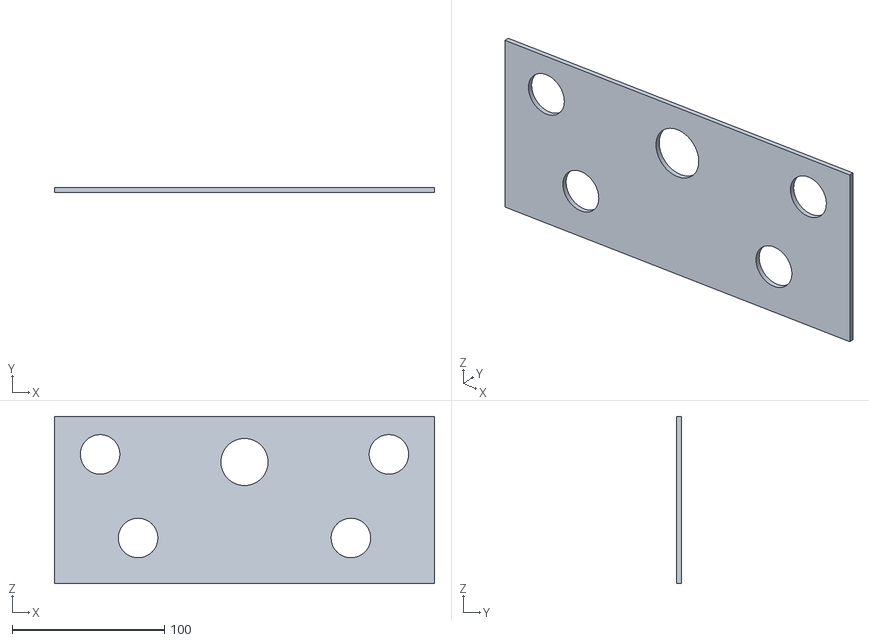
[picture p59: CAD file, 2026-10-28]
cad/out/stl/ST-11.stl
250.0 x 3.00 x 110.0
