positron-nb/starDust_wreckingball/cad/out/stl/HR-03.stl

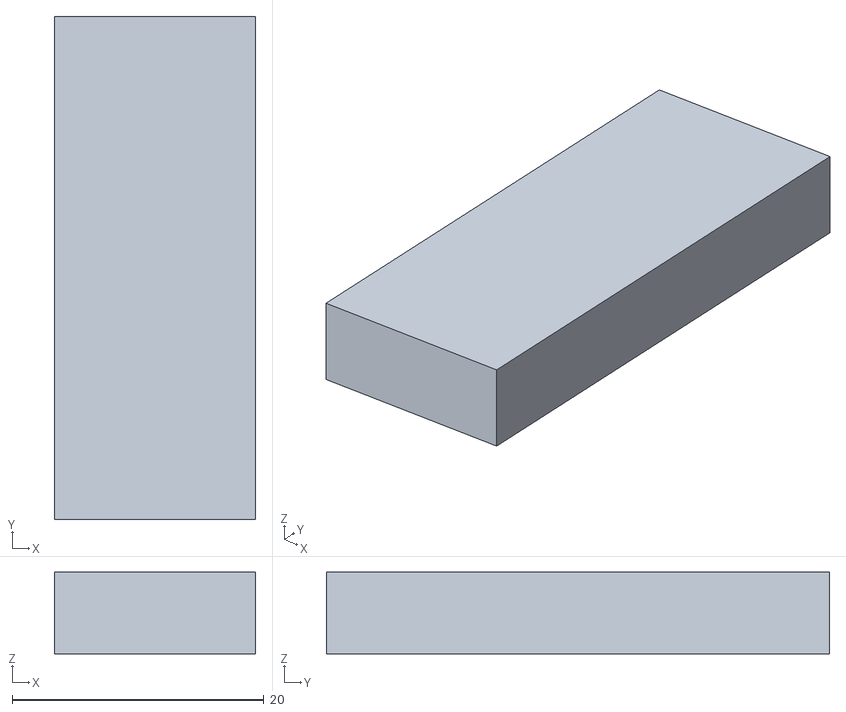
[picture p60: CAD file, 2026-10-28]
cad/out/stl/HR-03.stl
16.0 x 40.0 x 6.50
