positron-nb/starDust_wreckingball/cad/out/stl/ST-04.stl

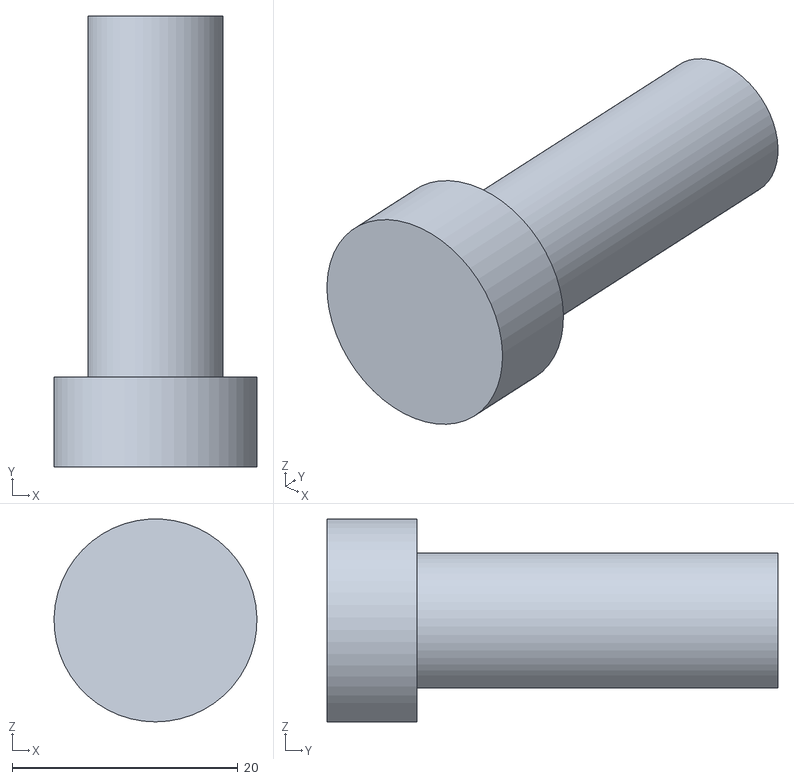
[picture p61: CAD file, 2026-10-28]
cad/out/stl/ST-04.stl
18.0 x 40.0 x 18.0
