positron-nb/starDust_wreckingball/cad/out/stl/DV-01.stl

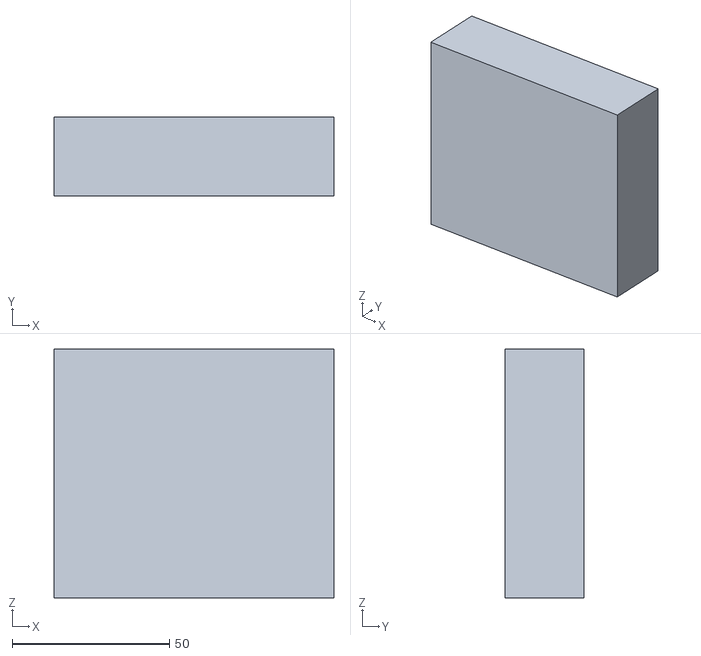
[picture p62: CAD file, 2026-10-28]
cad/out/stl/DV-01.stl
89.0 x 25.0 x 79.0
