positron-nb/starDust_wreckingball/cad/out/stl/SH-20.stl

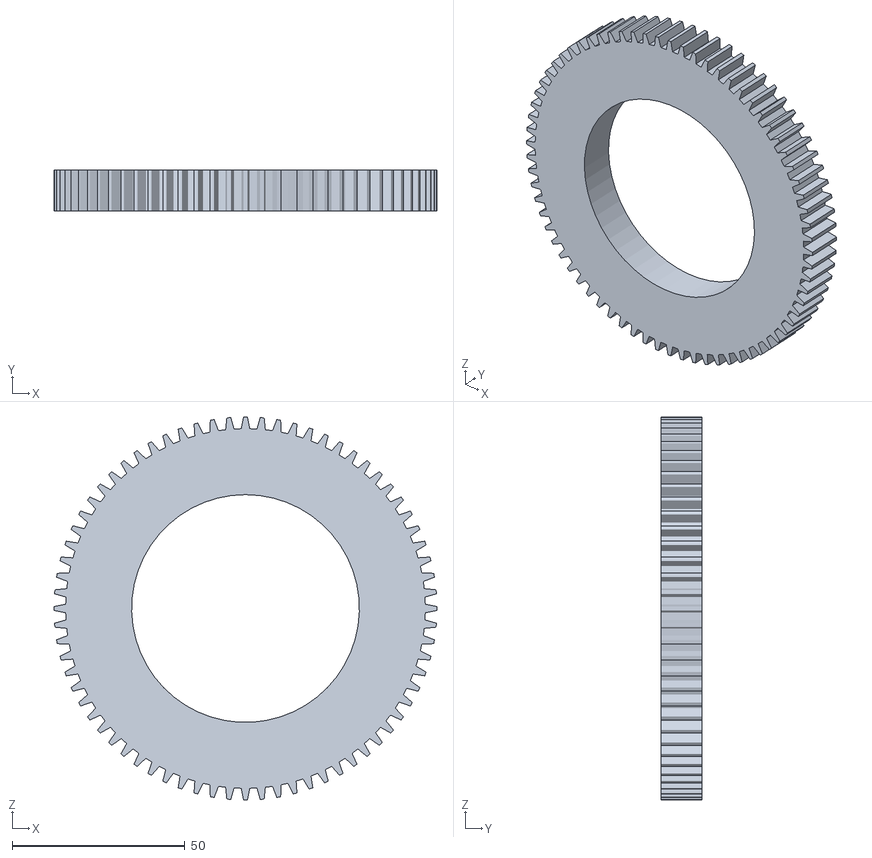
[picture p63: CAD file, 2026-10-28]
cad/out/stl/SH-20.stl
111.0 x 12.0 x 111.0
