positron-nb/starDust_wreckingball/cad/out/stl/PW-02.stl

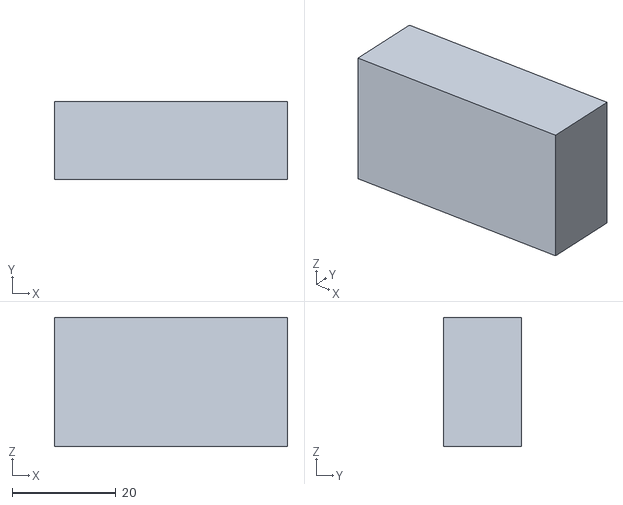
[picture p64: CAD file, 2026-10-28]
cad/out/stl/PW-02.stl
45.0 x 15.0 x 25.0
