positron-nb/starDust_wreckingball/cad/out/stl/ST-15.stl

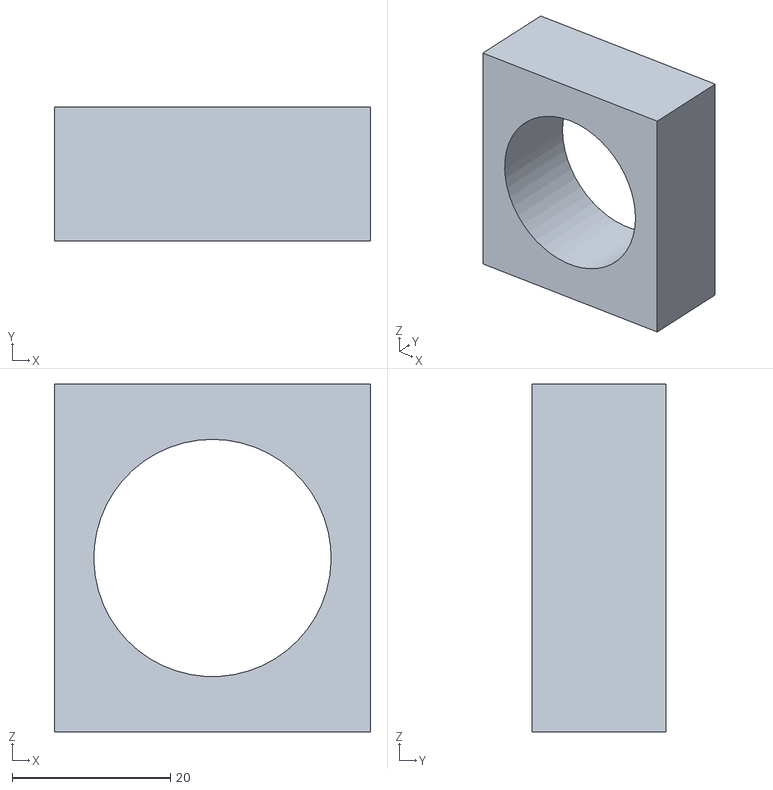
[picture p65: CAD file, 2026-10-28]
cad/out/stl/ST-15.stl
40.0 x 17.0 x 44.0
