positron-nb/starDust_wreckingball/cad/out/stl/SH-03.stl

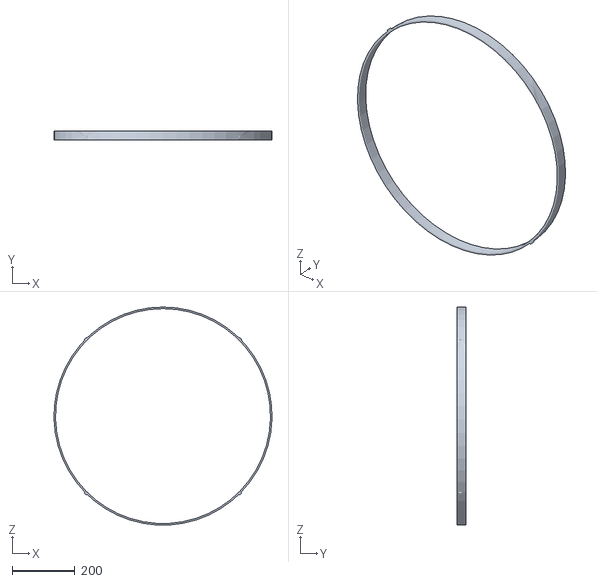
[picture p66: CAD file, 2026-10-28]
cad/out/stl/SH-03.stl
693.0 x 30.0 x 692.7
