positron-nb/starDust_wreckingball/cad/out/stl/SE-02.stl

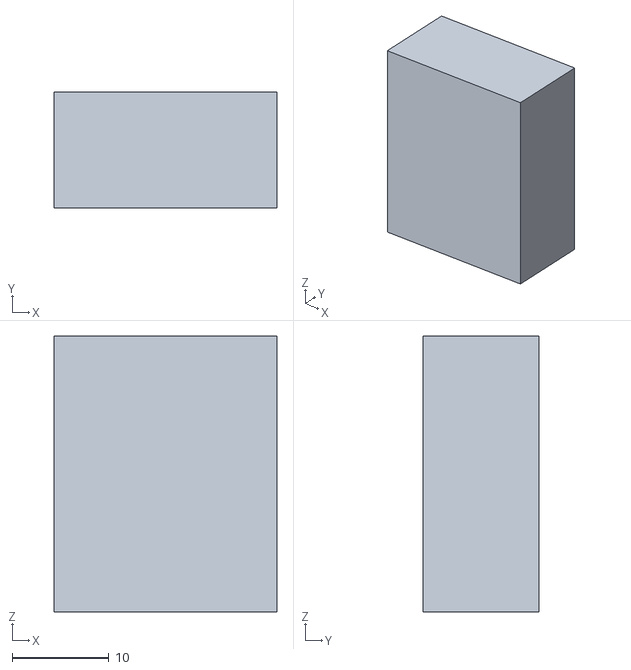
[picture p67: CAD file, 2026-10-28]
cad/out/stl/SE-02.stl
23.0 x 12.0 x 28.5
