positron-nb/starDust_wreckingball/cad/out/stl/DR-04.stl

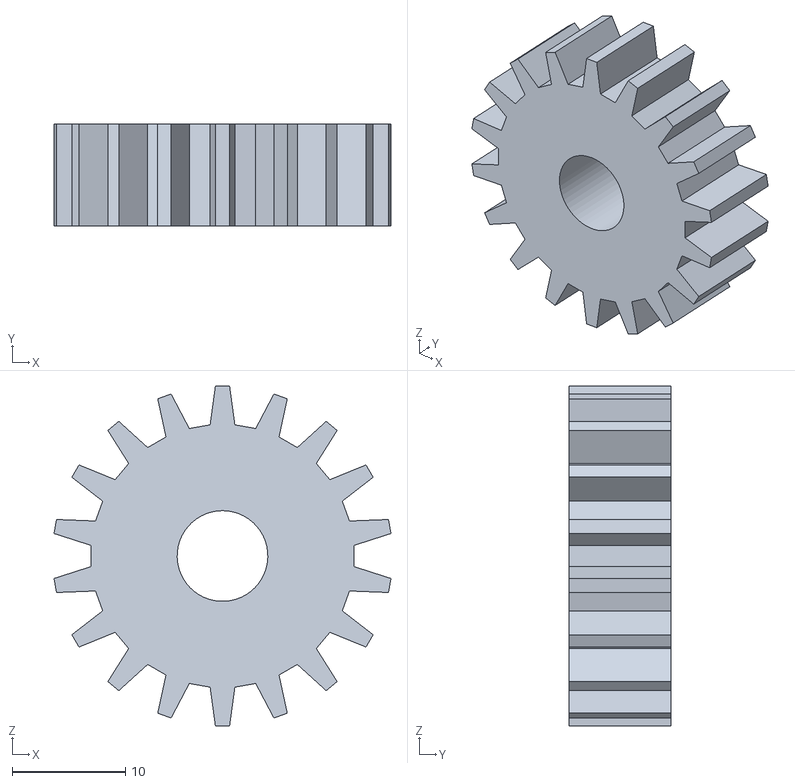
[picture p68: CAD file, 2026-10-28]
cad/out/stl/DR-04.stl
29.7 x 9.00 x 30.0
