positron-nb/starDust_wreckingball/cad/out/stl/SA-03.stl

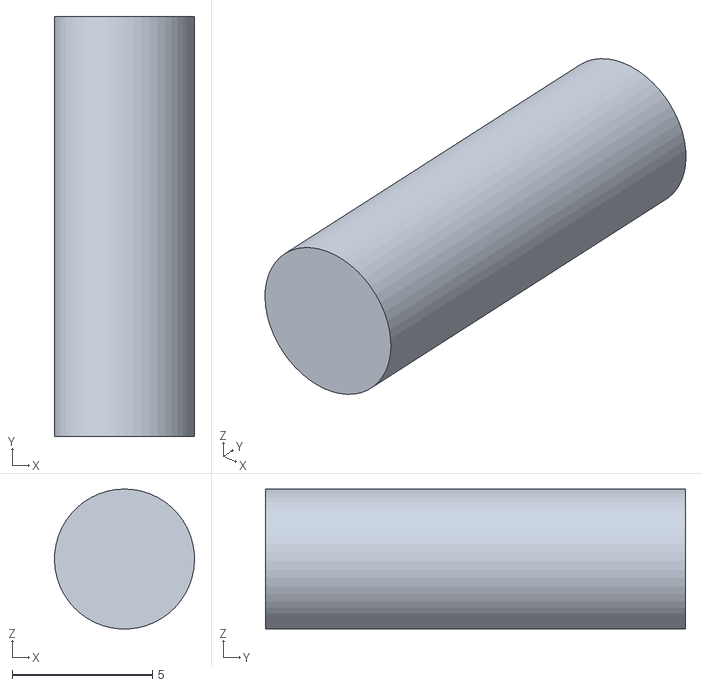
[picture p69: CAD file, 2026-10-28]
cad/out/stl/SA-03.stl
5.00 x 15.0 x 5.00
