positron-nb/starDust_wreckingball/cad/out/stl/ST-02.stl

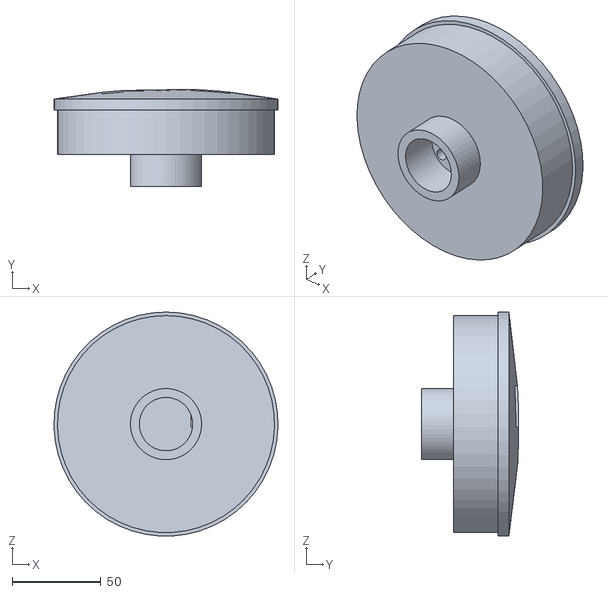
[picture p70: CAD file, 2026-10-28]
cad/out/stl/ST-02.stl
125.9 x 54.7 x 125.9
