positron-nb/starDust_wreckingball/cad/out/stl/ST-20.stl

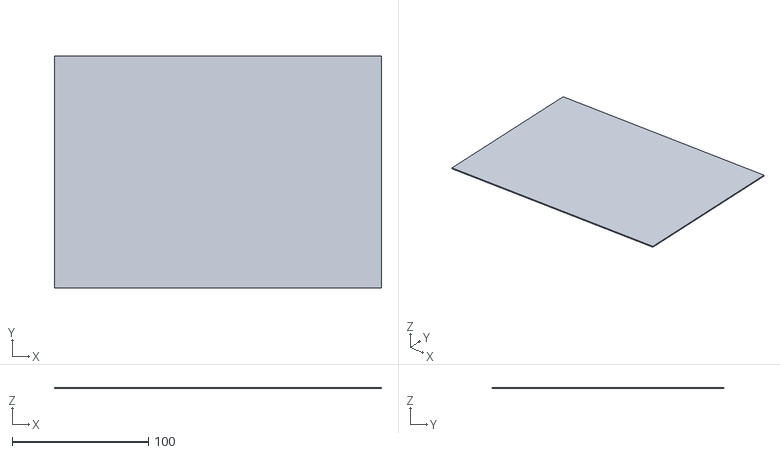
[picture p71: CAD file, 2026-10-28]
cad/out/stl/ST-20.stl
240.0 x 170.0 x 1.00
