positron-nb/starDust_wreckingball/cad/out/stl/SA-04.stl

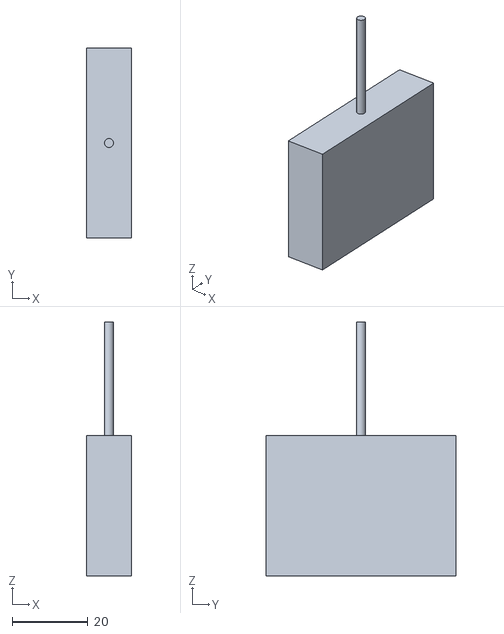
[picture p72: CAD file, 2026-10-28]
cad/out/stl/SA-04.stl
12.0 x 50.0 x 67.0
