positron-nb/starDust_wreckingball/cad/out/stl/PW-01.stl

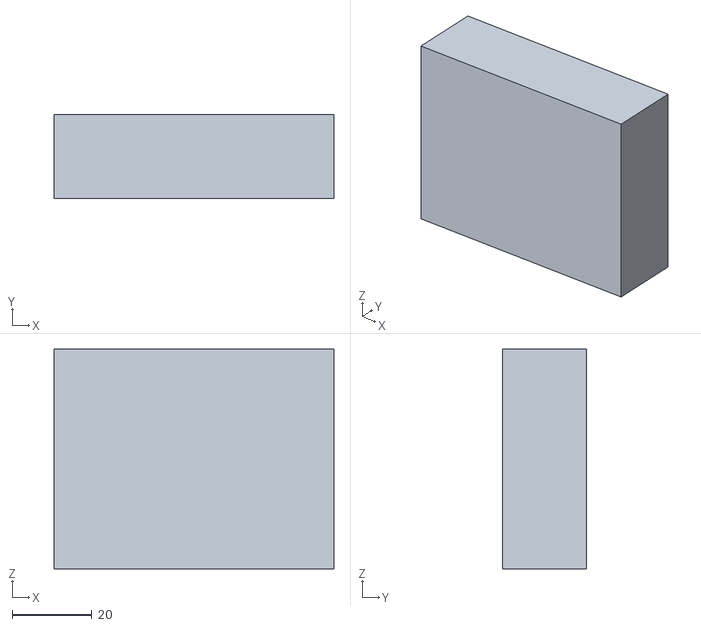
[picture p73: CAD file, 2026-10-28]
cad/out/stl/PW-01.stl
70.0 x 21.0 x 55.0
