positron-nb/starDust_wreckingball/cad/out/stl/ST-01.stl

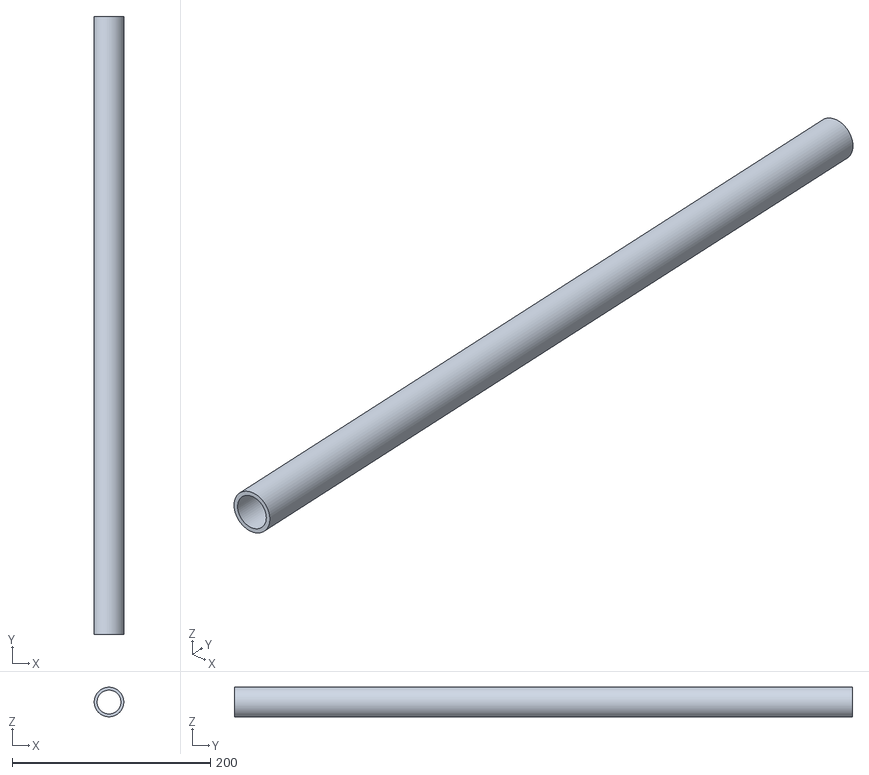
[picture p74: CAD file, 2026-10-28]
cad/out/stl/ST-01.stl
30.0 x 624.0 x 30.0
