positron-nb/starDust_wreckingball/cad/out/stl/SG-01.stl

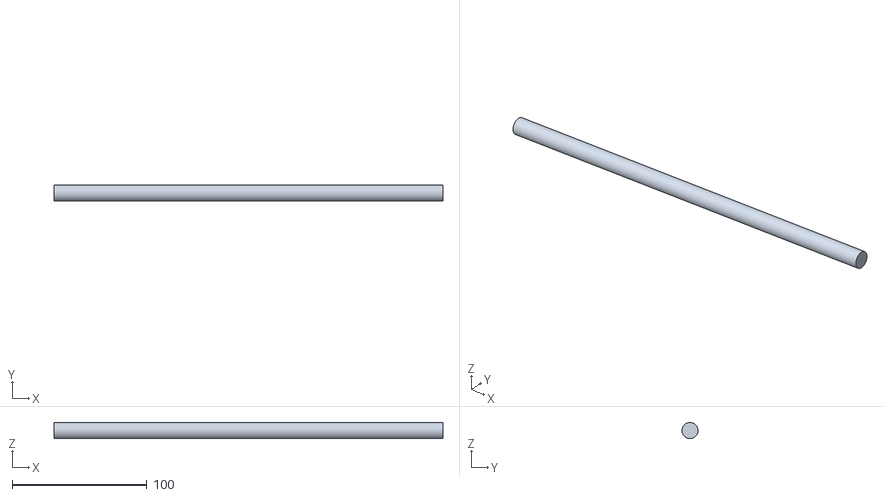
[picture p75: CAD file, 2026-10-28]
cad/out/stl/SG-01.stl
289.0 x 12.0 x 12.0
