positron-nb/starDust_wreckingball/cad/out/stl/SA-01.stl

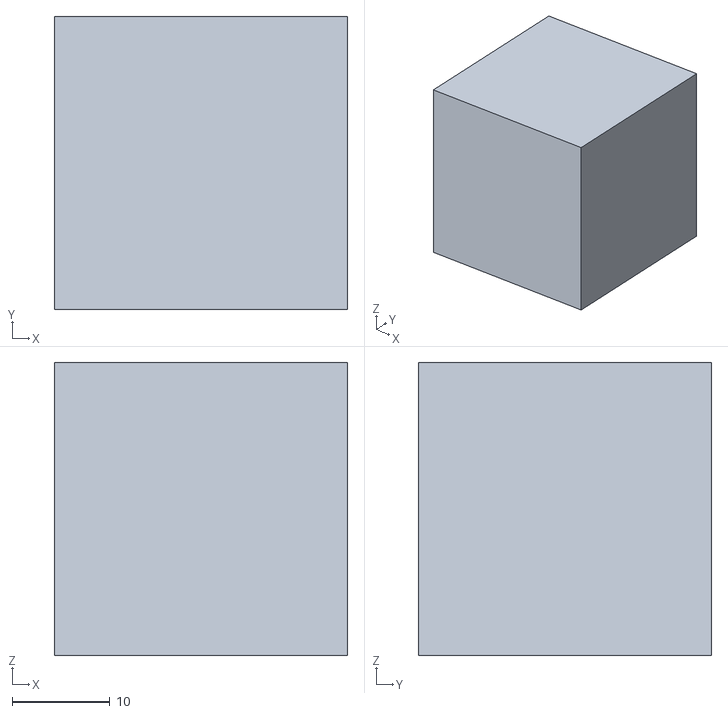
[picture p76: CAD file, 2026-10-28]
cad/out/stl/SA-01.stl
30.0 x 30.0 x 30.0
