positron-nb/starDust_wreckingball/cad/out/stl/DV-02.stl

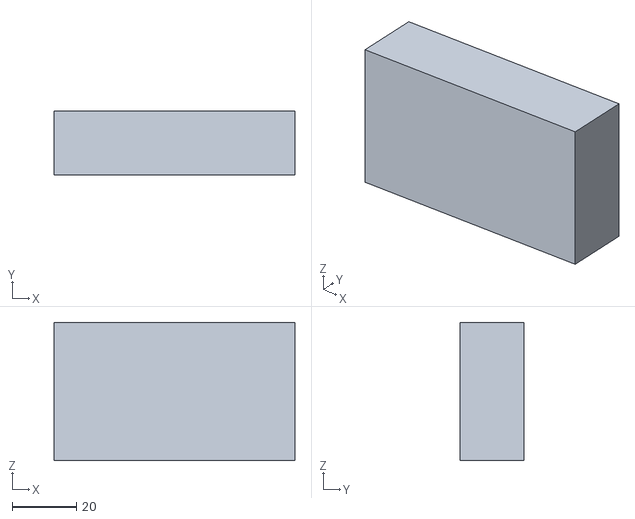
[picture p77: CAD file, 2026-10-28]
cad/out/stl/DV-02.stl
75.0 x 20.0 x 43.0
