positron-nb/starDust_wreckingball/cad/out/stl/BB-01.stl

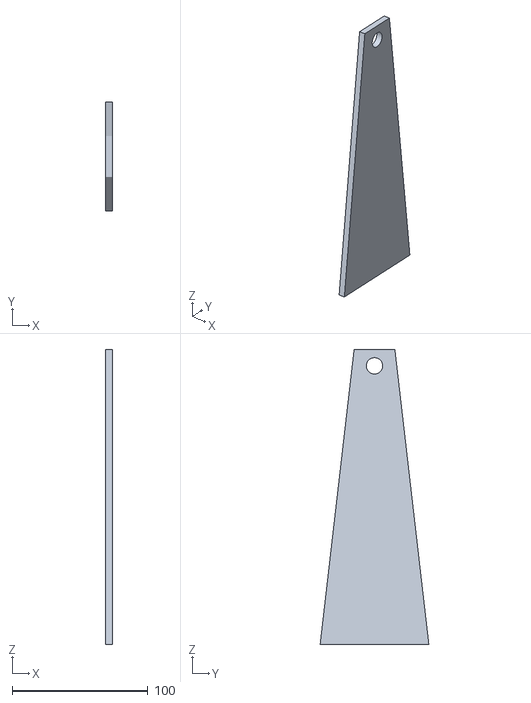
[picture p78: CAD file, 2026-10-28]
cad/out/stl/BB-01.stl
5.00 x 80.0 x 217.0
