positron-nb/starDust_wreckingball/(list of files, cad)

Other CAD files:
cad/out/stl/SG-02.stl
cad/out/stl/SH-11.stl
cad/out/stl/BL-04.stl
cad/out/stl/BL-03.stl
cad/out/stl/DR-02.stl
cad/out/stl/SH-30.stl
cad/out/stl/BL-01.stl
cad/out/stl/SG-10.stl
cad/out/stl/DR-06.stl
cad/out/stl/HR-02.stl
cad/out/stl/SH-21.stl
cad/out/stl/ST-14.stl
cad/out/stl/ST-13.stl
cad/out/stl/SG-12.stl
cad/out/stl/DR-03.stl
cad/out/stl/ST-10.stl
cad/out/stl/SG-11.stl
cad/out/stl/SH-02.stl
cad/out/stl/BB-04.stl
cad/out/stl/ST-03.stl
cad/out/stl/BB-02.stl
