positron-nb/starDust_wreckingball/PROGRESS_LOG.md

# Phase 1 progress log

| Date | Step | Outcome |
|---|---|---|
| 2026-10-20 | 1. Requirements | Found and read the 5-page problem statement (`Downloads\Ultraviollete_PS_2_compressed.pdf`, copied to `reference/`). Official page read in a browser: dates identical (Phase 1 = Oct 25, 2026). **Found the official Round 1 submission template** (Google Doc), which requires preliminary motor torque/selection, a manual external disconnect and a software flowchart. |
| 2026-10-20 | 2. Extraction | Requirements and unresolved inputs listed; organiser questions drafted. |
| 2026-10-20 | 3. Research | SphBot (MIT), Rollie (MIT), Integral-Robotics-Lab (no licence) reviewed; literature citations verified (Chase & Pandya 2012, Halme 1996, Ylikorpi 2017). Datasheets checked: Camera Module 3, Molicel P45B, 3M 8671, Pi 5, Cytron drivers. |
| 2026-10-20 | 4. Architecture | Two-axis pendulum with a stationary through-axle stator selected over the IDU and twin-hemisphere options. Belt drive replaced by spur gears so a hemisphere can slide off without releasing tension. |
| 2026-10-20 | Environment | OpenSCAD and FreeCAD not installed. CadQuery 2.8 (OCCT) chosen; project `.venv` created; Edge headless used for diagrams and PDFs. |
| 2026-10-20/21 | 5. CAD | 68-part parametric assembly; STEP/STL/GLB export. Iterations: ballast moved to the bob ends after the battery-removal check failed; camera pitch-sign bug fixed; 2 mm shaft-to-flange gap added. |
| 2026-10-21 | 6. Mass and CG | 17.00 kg, CG (+1.4, -0.4, -87.2) mm; ballast sweep 2-6 plates; steering lean ±22.9°. |
| 2026-10-21 | Checks | Diameter 696.3-700.7 mm PASS; 0 external protrusions; 0 clashes in 6 states; ≥ 19.98 mm frame/bob to shell; camera 0 % blocked; battery path clear. |
| 2026-10-21 | 7. Diagrams | Mermaid auto-layout rejected (unreadable when printed); explicit-layout SVG kit built; system, electronics, power and software diagrams produced, with Mermaid exports from the same data. |
| 2026-10-21 | 8. Documents | Abstract (template-aligned) and 21-section TDD generated from the analysis results; compliance CSV (40 rows) and BOM CSV (49 lines). |
| 2026-10-21 | 9. Export and QA | PDFs rendered and inspected page by page. Fixed: landscape pages for wide diagrams, stranded headings, merged header lines, a table broken by a pipe character, a stale part count. DOCX built. |
| 2026-10-21 | 10. Reports | README, standby list and completion report written. |
| 2026-10-21 | 11. Google Doc | Team's `wrecking_ball` Google Doc filled in place through the Google Docs connector (same file and link), styled like the official template (Verdana, bold Heading 3 sections, bullet fields with bold/italic labels). Read back: 53 paragraphs, text and styles match with 0 differences; PDF export inspected (5 pages). The 9 figures are marked spots for the team to insert (the Docs API only inserts images from a public URL). Wording fix carried back to the abstract source: hubs sit "1.0 mm inside" the surface (was "-1.0 mm inside"); documents rebuilt, quality gate ALL PASS. |
| 2026-10-24 | 12. Google Doc figures | Supporting folder `WB-700_Phase1_Supporting_Material` (TDD PDF, STEP, 12 figures) uploaded to the doc owner's Drive and link-shared. All 9 figures inserted at their markers from the folder; folder link (hyperlinked) placed in both former `[GOOGLE DRIVE LINK]` spots. PDF export checked: 10 pages, 9 images, each above its caption. |
| 2026-10-24 | 13. External review | Reviewed an outside model's 8-point critique against the CAD data. Accepted and fixed: climb limit now includes rolling resistance (12.4° → 10.7°, ballast 7.1-13.6°); run-up labelled energy-only; motor operating points with 18 V check (no-load target raised 280 → 320 rpm); new Steering_Mechanism figure; axle/bearing load path described; e-stop corrected to the real driver pins (PWM gate, no ENABLE pin) with changeover break-before-make brake relays; camera check extended to 9 bob/servo poses; quantified pendulum-crossing policy. Sources, figures and diagrams rebuilt, quality gate ALL PASS; Google Doc text updated (images pending re-upload). |
| 2026-10-24 | 14. Second review | Astra's consistency check: team details filled into both PDFs (members still to add); R1 6-plate value 15.3° → 13.6°; R8 antenna made internal; e-stop override added to the crossing policy (abstract, TDD, Google Doc); power-diagram brown-out claim replaced with a verification-pending note; R-24 and R-27 set to Partially satisfied ("addressed in design; verification pending"); supervisor-freeze behaviour and a motor-selection evidence table (pending) added to the TDD; verification zip (CSVs, JSON, scripts) staged. No "+++" found in the Google Doc. Quality gate ALL PASS. |
